Killerpk06/racebot_newchassis/64474a38-f25e-43dd-9ca9-c614ded4e5b5.png

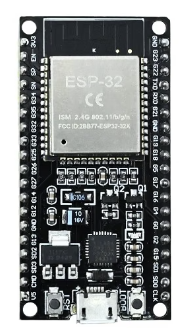
64474a38-f25e-43dd-9ca9-c614ded4e5b5.png
