Killerpk06/racebot_newchassis/chassis/racebot_chassis_iso.png

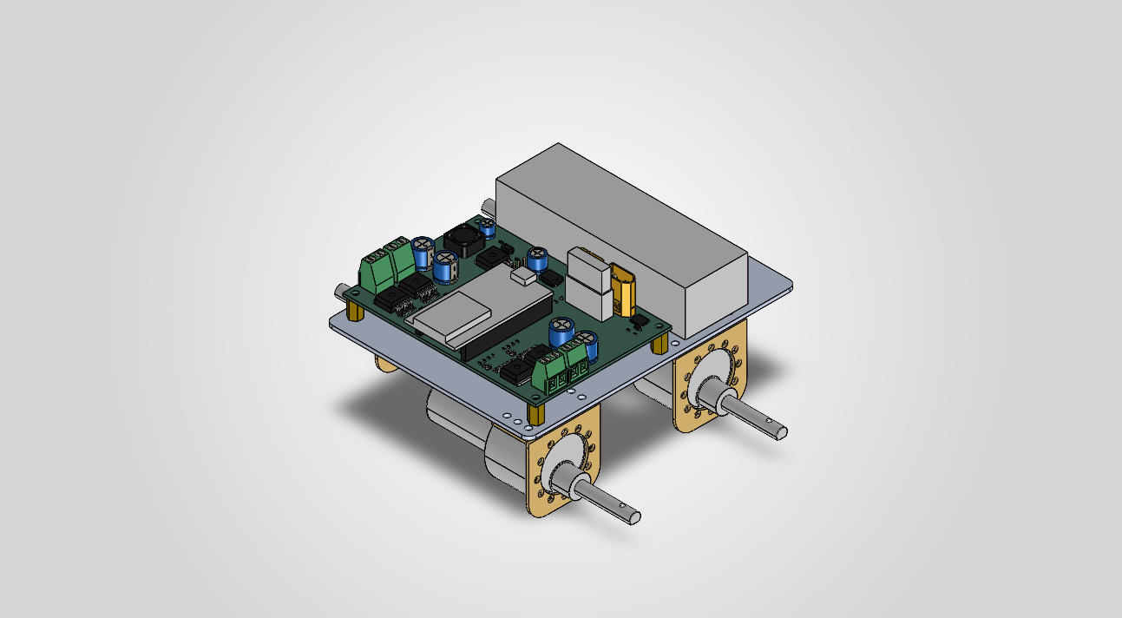
chassis/racebot_chassis_iso.png
