Killerpk06/racebot_newchassis/WhatsApp Image 2026-10-13 at 14.18.45.jpeg

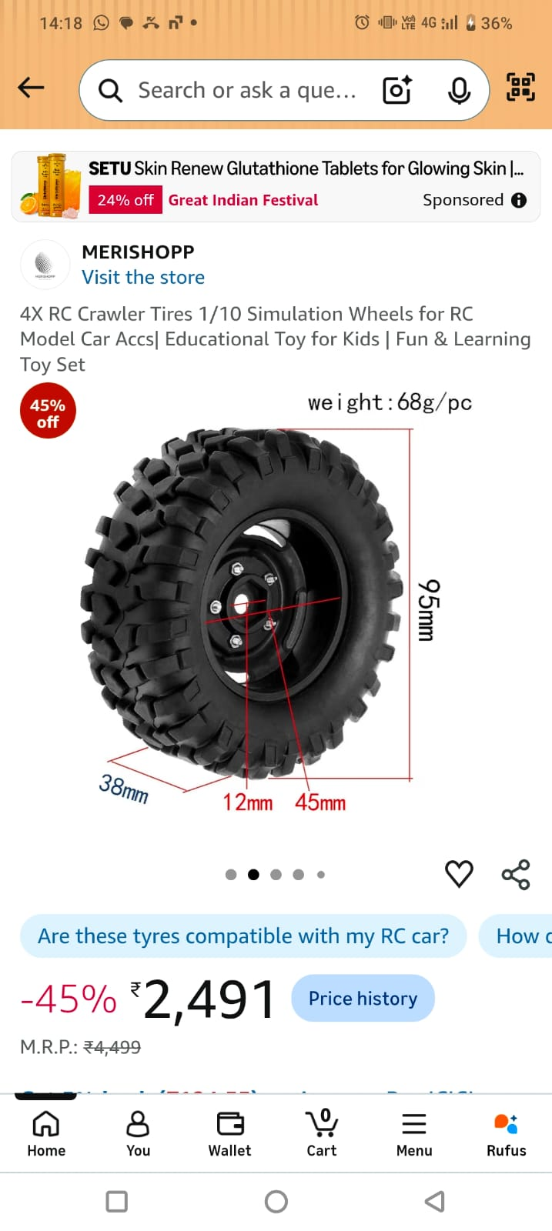
WhatsApp Image 2026-10-13 at 14.18.45.jpeg
