Killerpk06/racebot_newchassis/pcb/racebot_main_bom.csv

Designator | Value | Footprint | MPN | LCSC | Qty | Note
C101 | 220uF 35V | Capacitor_THT:CP_Radial_D8.0mm_P3.50mm | NXH35V220M8*11.5 3.5TP | C346959 | 1
C102,C104,C105,C301,C403,C406,C503,C506 | 100nF 50V X7R | Capacitor_SMD:C_0603_1608Metric | CC0603KRX7R9BB104 | C14663 | 8
C103 | 220uF 16V low-ESR | Capacitor_THT:CP_Radial_D6.3mm_P2.50mm | 16YXJ220M6.3X11 | C88757 | 1
C401,C404,C501,C504 | 10nF 50V X7R | Capacitor_SMD:C_0603_1608Metric | 0603B103K500NT | C57112 | 4
C402,C405,C502,C505 | 470nF 50V X7R | Capacitor_SMD:C_0805_2012Metric | CL21B474KBFNNNE | C13967 | 4
C407,C408,C507,C508 | 470uF 25V low-ESR | Capacitor_THT:CP_Radial_D10.0mm_P5.00mm | GA25V470M10X12 | C51018322 | 4
D101 | BZT52C12 | Diode_SMD:D_SOD-123 | LBZT52C12T1G | C12747 | 1
D102 | SMCJ15A | Diode_SMD:D_SMC | SMCJ15A-13-F | C135138 | 1 | Unidirectional TVS 15 V standoff, clamps ~24.4 V
D103 | SS34 | Diode_SMD:D_SMA | SS34 | C8678 | 1
D104 | RED 5V | LED_SMD:LED_0603_1608Metric | KT-0603R | C2286 | 1
D105 | RED VMOT | LED_SMD:LED_0603_1608Metric | KT-0603R | C2286 | 1
D201 | RED STATUS | LED_SMD:LED_0603_1608Metric | KT-0603R | C2286 | 1
D401,D402,D501,D502 | BAT54S | Package_TO_SOT_SMD:SOT-23 | BAT54S | C8592 | 4
F101 | 30A ATO | Fuse:FuseHolder_Blade_ATO_Littelfuse_FLR_178.6165 | 178.6165.0002 | C207061 | 1 | ATO holder; fit 30 A ATO blade fuse
J101 | XT60 BATTERY | Connector_AMASS:AMASS_XT60-M_1x02_P7.20mm_Vertical | XT60PB-M.G.Y | C19268037 | 1 | vertical; pin1 (bevelled end) = -, pin2 = +. Check against battery plug
J102 | PWR SWITCH / KILL LINK | Connector_AMASS:AMASS_XT60-F_1x02_P7.20mm_Vertical | XT60PB-F.G.Y | C19268038 | 1 | Plug a shorted XT60 link, or a >=30 A switch on an XT60 lead. See LAYOUT_NOTES.md
J201 | ESP32 DevKit left row | Connector_PinSocket_2.54mm:PinSocket_1x19_P2.54mm_Vertical | 2.54-1*19PFemale | C319202 | 1
J202 | ESP32 DevKit right row | Connector_PinSocket_2.54mm:PinSocket_1x19_P2.54mm_Vertical | 2.54-1*19PFemale | C319202 | 1
J203 | ELRS RX (5V GND TX RX) | Connector_PinHeader_2.54mm:PinHeader_1x04_P2.54mm_Vertical | PZ254V-11-04P | C492403 | 1
J401 | M_L1 | TerminalBlock_Phoenix:TerminalBlock_Phoenix_MKDS-1,5-2-5.08_1x02_P5.08mm_Horizontal | 1729128 | C7509570 | 1 | front pad = L_OUT_A
J402 | M_L2 | TerminalBlock_Phoenix:TerminalBlock_Phoenix_MKDS-1,5-2-5.08_1x02_P5.08mm_Horizontal | 1729128 | C7509570 | 1 | front pad = L_OUT_A
J501 | M_R1 | TerminalBlock_Phoenix:TerminalBlock_Phoenix_MKDS-1,5-2-5.08_1x02_P5.08mm_Horizontal | 1729128 | C7509570 | 1 | front pad = R_OUT_A
J502 | M_R2 | TerminalBlock_Phoenix:TerminalBlock_Phoenix_MKDS-1,5-2-5.08_1x02_P5.08mm_Horizontal | 1729128 | C7509570 | 1 | front pad = R_OUT_A
L101 | 33uH 4.6A | Inductor_SMD:L_Bourns_SRR1260 | SRR1260-330M | C840528 | 1
Q101 | CSD18540Q5B | Package_TO_SOT_SMD:TDSON-8-1 | CSD18540Q5B | C86513 | 1
R101,R301,R302,R303,R304,R305,R306,R401,R402,R406,R407,R501,R502,R506,R507 | 10k | Resistor_SMD:R_0603_1608Metric | 0603WAF1002T5E | C25804 | 15 | IN series,INH series,boot pull-down
R102,R103 | 100k | Resistor_SMD:R_0603_1608Metric | 0603WAF1003T5E | C25803 | 2
R104 | 22k | Resistor_SMD:R_0603_1608Metric | 0603WAF2202T5E | C31850 | 1
R105,R201,R405,R410,R505,R510 | 1k | Resistor_SMD:R_0603_1608Metric | 0603WAF1001T5E | C21190 | 6 | IS RC filter
R106 | 4.7k | Resistor_SMD:R_0603_1608Metric | 0603WAF4701T5E | C23162 | 1
R403,R408,R503,R508 | 5.1k | Resistor_SMD:R_0603_1608Metric | 0603WAF5101T5E | C23186 | 4 | slew: fit 0R / 51k to tune
R404,R409,R504,R509 | 470 | Resistor_SMD:R_0603_1608Metric | 0603WAF4700T5E | C23179 | 4 | IS load
U101 | LM2596S-5.0 | Package_TO_SOT_SMD:TO-263-5_TabPin3 | LM2596S-5.0/NOPB | C116713 | 1
U301 | 74HCT244 | Package_SO:SOIC-20W_7.5x12.8mm_P1.27mm | 74HCT244D,653 | C5978 | 1
U401,U402,U501,U502 | BTS7960B | Package_TO_SOT_SMD:TO-263-7_TabPin8 | BTS7960B | C5122776 | 4
