Killerpk06/racebot_newchassis/pcb/mech/racebot_main_outline.dxf

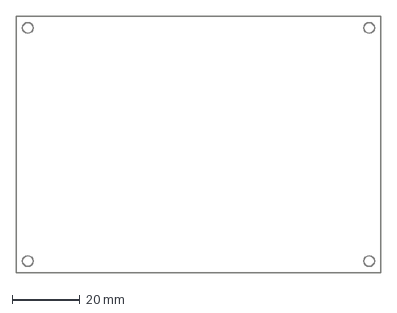
[picture p4: CAD file, 2026-10-28]
pcb/mech/racebot_main_outline.dxf
108.0 x 76.0 mm
