Killerpk06/racebot_newchassis/pcb/mech/racebot_main.step

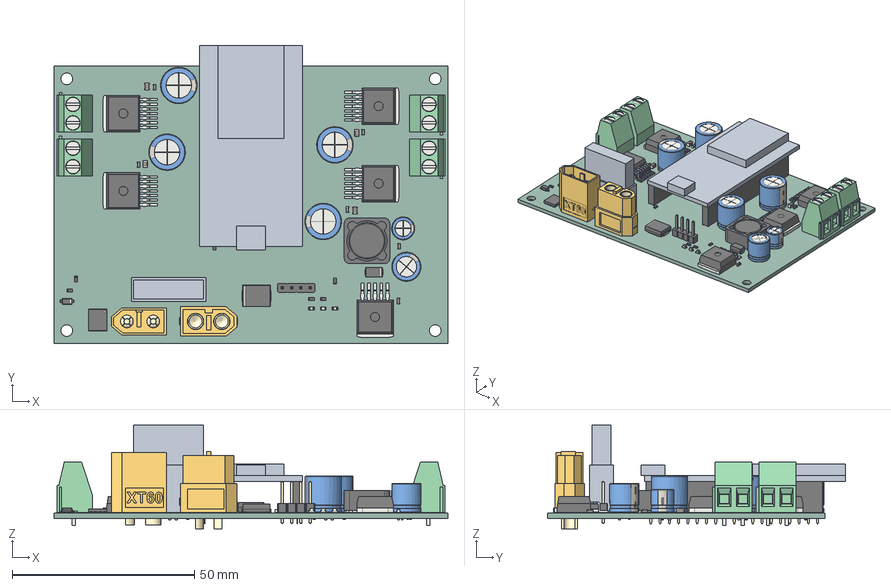
[picture p5: CAD file, 2026-10-28]
pcb/mech/racebot_main.step
108.0 x 81.6 x 28.5 mm
D_SOD-123
C_0603_1608Metric x 12
SOT-23 x 4
a87cca41-9c39-11ed-93f0-dde97e994e83_part x 4
a87cca42-9c39-11ed-93f0-dde97e994e83_part x 4
a87cca43-9c39-11ed-93f0-dde97e994e83_part x 4
R_0603_1608Metric x 33
LED_0603_1608Metric x 3
CP_Radial_D100mm_P500mm x 4
C_0805_2012Metric x 4
TerminalBlock_Phoenix_MKDS-1,5-2-5.08_1x02_P5.08mm_Horizontal x 4
D_SMC
CP_Radial_D80mm_P350mm
D_SMA
XT60 male v2
PinSocket_1x19_P2.54mm_Vertical x 2
SRR1260
a648ce37-9c39-11ed-93f0-dde97e994e83_part
a648ce38-9c39-11ed-93f0-dde97e994e83_part
a648ce39-9c39-11ed-93f0-dde97e994e83_part
TDSON_8_1
CP_Radial_D63mm_P250mm
XT60 female v5
PinHeader_1x04_P254mm_Vertical
SOIC-20W_7.5x12.8mm_P1.27mm
racebot_main_PCB
