Killerpk06/racebot_newchassis/chassis/parts/johnson_L_clamp.step

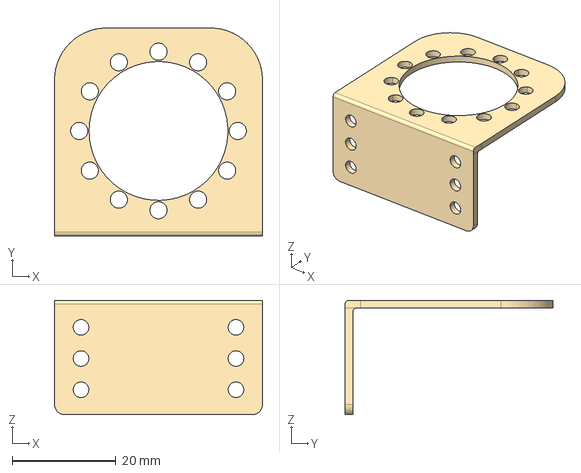
[picture p6: CAD file, 2026-10-28]
chassis/parts/johnson_L_clamp.step
40.0 x 40.0 x 22.0 mm
