Killerpk06/racebot_newchassis/chassis/racebot_chassis.step

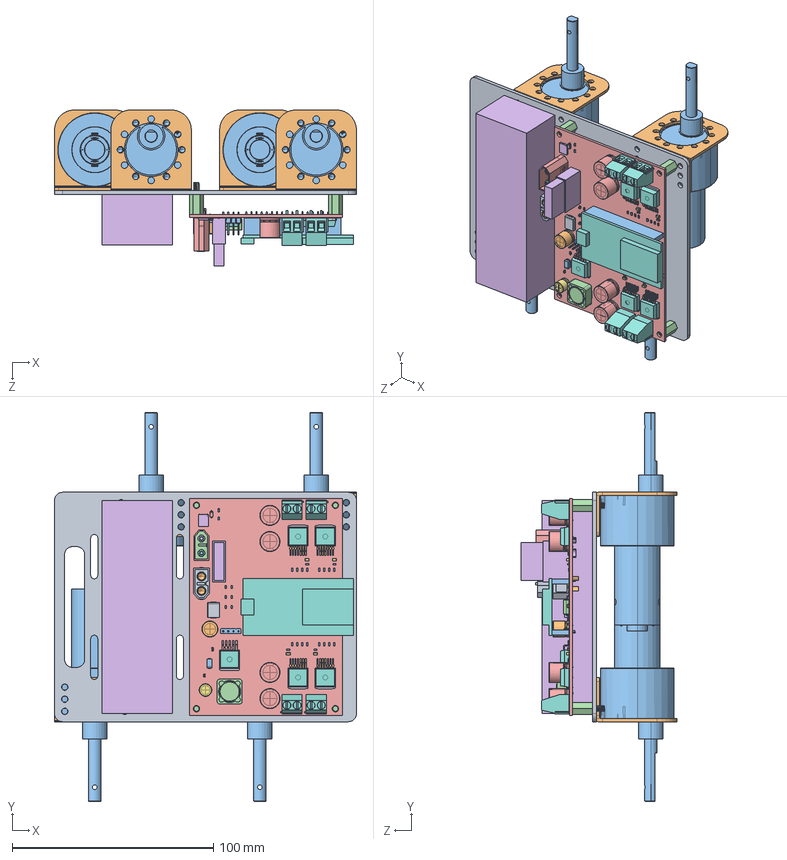
[picture p7: CAD file, 2026-10-28]
chassis/racebot_chassis.step
150.0 x 193.2 x 77.6 mm
racebot_deck
johnson_L_clamp x 4
johnson_motor x 4
M3x10_spacer x 4
D_SOD-123-0.step
C_0603_1608Metric-1.step x 12
SOT-23-2.step x 4
a87cca41-9c39-11ed-93f0-dde97e994e83_part.step x 4
a87cca42-9c39-11ed-93f0-dde97e994e83_part.step x 4
a87cca43-9c39-11ed-93f0-dde97e994e83_part.step x 4
R_0603_1608Metric-3.step x 33
LED_0603_1608Metric-4.step x 3
CP_Radial_D100mm_P500mm.step x 4
C_0805_2012Metric-5.step x 4
TerminalBlock_Phoenix_MKDS-1,5-2-5.08_1x02_P5.08mm_Horizontal-6.step x 4
D_SMC-7.step
CP_Radial_D80mm_P350mm.step
D_SMA-8.step
XT60 male v2.step
PinSocket_1x19_P2.54mm_Vertical-9.step x 2
SRR1260.step
a648ce37-9c39-11ed-93f0-dde97e994e83_part.step
a648ce38-9c39-11ed-93f0-dde97e994e83_part.step
a648ce39-9c39-11ed-93f0-dde97e994e83_part.step
TDSON_8_1.step
CP_Radial_D63mm_P250mm.step
XT60 female v5.step
PinHeader_1x04_P254mm_Vertical.step
SOIC-20W_7.5x12.8mm_P1.27mm-10.step
racebot_main_PCB.step
battery_3S_2200_envelope
