Killerpk06/racebot_newchassis/pcb/3d/XT60_male_vertical.step

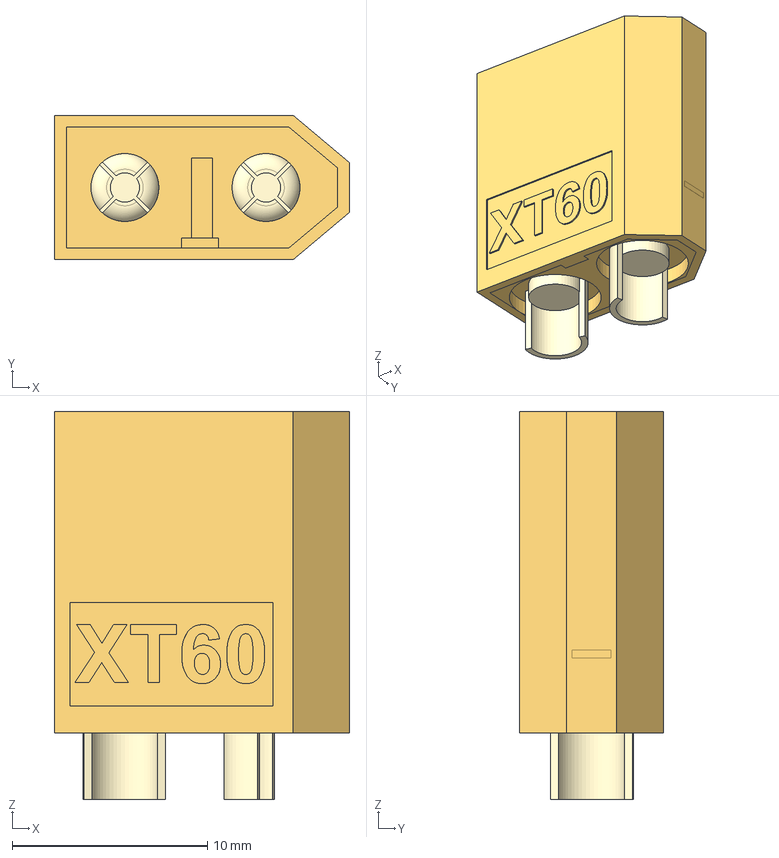
[picture p8: CAD file, 2026-10-28]
pcb/3d/XT60_male_vertical.step
15.1 x 7.40 x 19.9 mm
