Killerpk06/racebot_newchassis/Robo Race chasis final.dxf

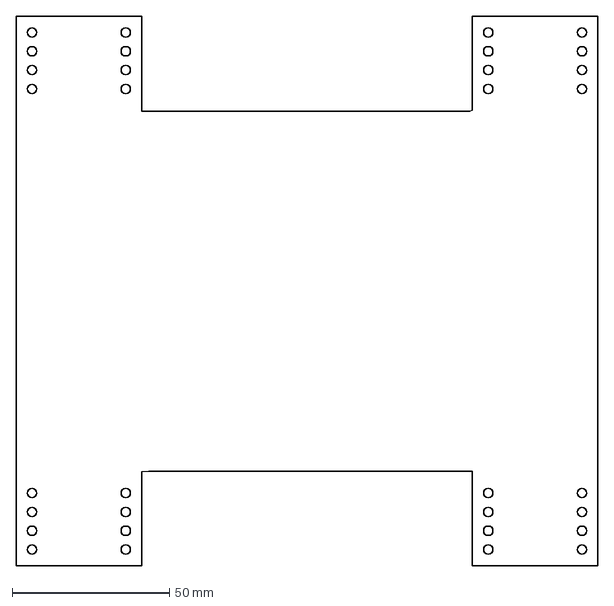
[picture p9: CAD file, 2026-10-28]
Robo Race chasis final.dxf
185.2 x 175.0 mm
