Killerpk06/racebot_newchassis/chassis/racebot_deck_2mm_6061.dxf

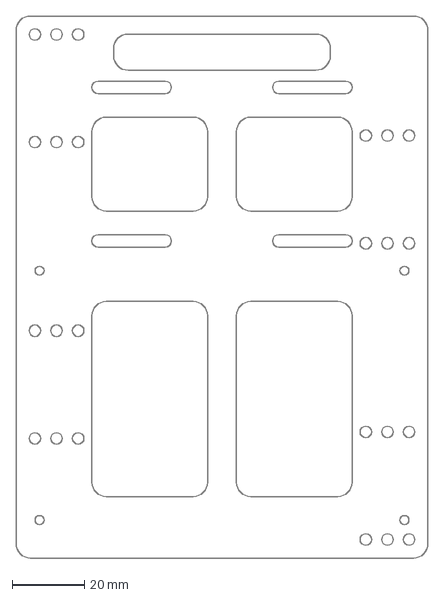
[picture p10: CAD file, 2026-10-28]
chassis/racebot_deck_2mm_6061.dxf
114.0 x 150.0 mm
