Killerpk06/racebot_newchassis/pcb/3d/ESP32_DevKit38_on_sockets_envelope.step

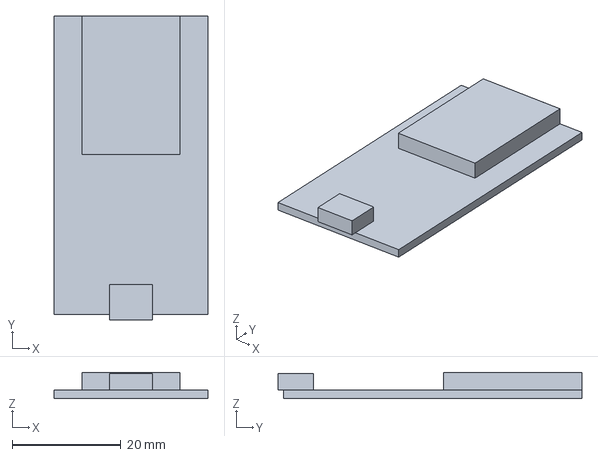
[picture p11: CAD file, 2026-10-28]
pcb/3d/ESP32_DevKit38_on_sockets_envelope.step
28.3 x 56.0 x 4.80 mm
