Killerpk06/racebot_newchassis/chassis/racebot_deck.SLDPRT

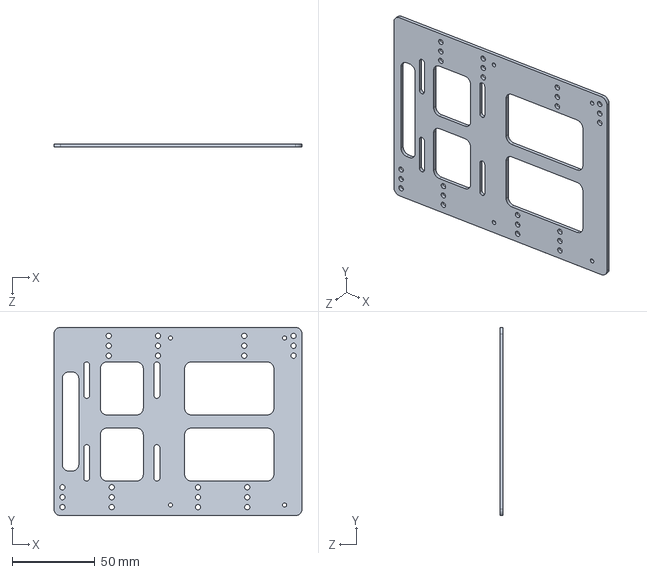
[picture p12: CAD file, 2026-10-28]
chassis/racebot_deck.SLDPRT
150.0 x 114.0 x 2.00 mm
