Killerpk06/racebot_newchassis/pcb/3d/ATO_holder_with_fuse_envelope.step

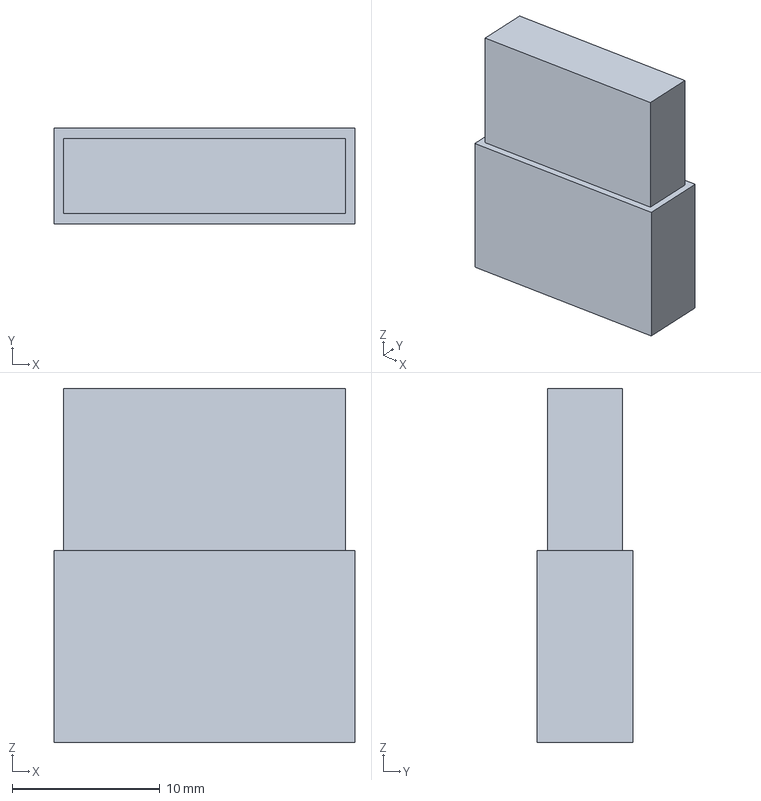
[picture p13: CAD file, 2026-10-28]
pcb/3d/ATO_holder_with_fuse_envelope.step
20.4 x 6.50 x 24.0 mm
