Killerpk06/racebot_newchassis/chassis/parts/johnson_motor.step

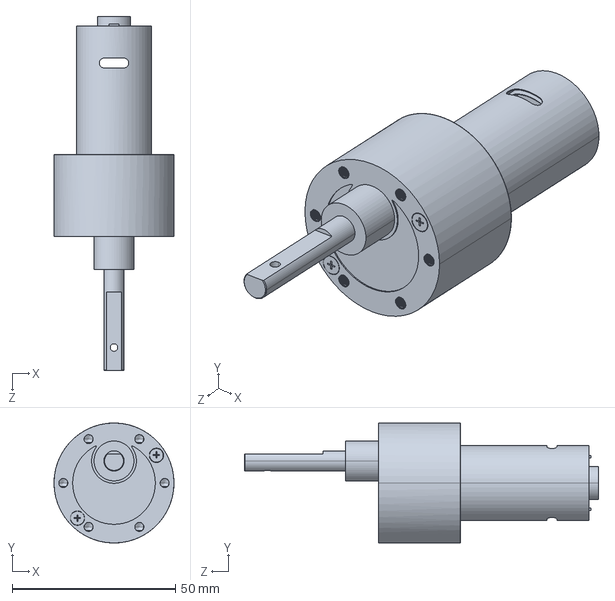
[picture p14: CAD file, 2026-10-28]
chassis/parts/johnson_motor.step
36.7 x 36.7 x 108.4 mm
