Killerpk06/racebot_newchassis/chassis/parts/battery_3S_2200_envelope.SLDPRT

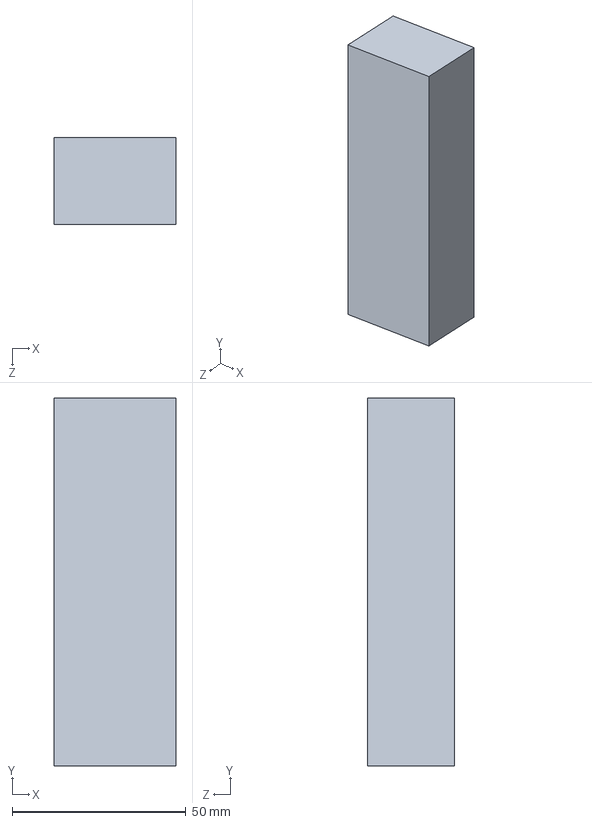
[picture p15: CAD file, 2026-10-28]
chassis/parts/battery_3S_2200_envelope.SLDPRT
35.0 x 106.0 x 25.0 mm
