Killerpk06/racebot_newchassis/chassis/parts/M3x10_spacer.SLDPRT

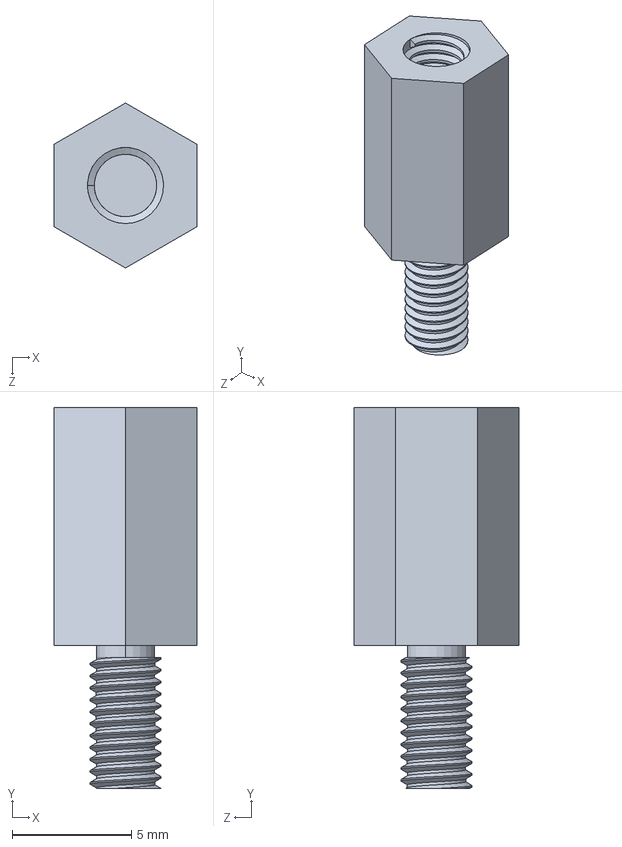
[picture p16: CAD file, 2026-10-28]
chassis/parts/M3x10_spacer.SLDPRT
6.00 x 16.0 x 6.93 mm
