Killerpk06/racebot_newchassis/(list of files, cad)

Other CAD files:
chassis/parts/racebot_pcb.step
chassis/parts/johnson_L_clamp.SLDPRT
chassis/parts/johnson_motor.SLDPRT
chassis/parts/racebot_pcb.SLDASM
chassis/racebot_chassis.SLDASM
