Killerpk06/racebot_newchassis/pcb/racebot_main_schematic.pdf

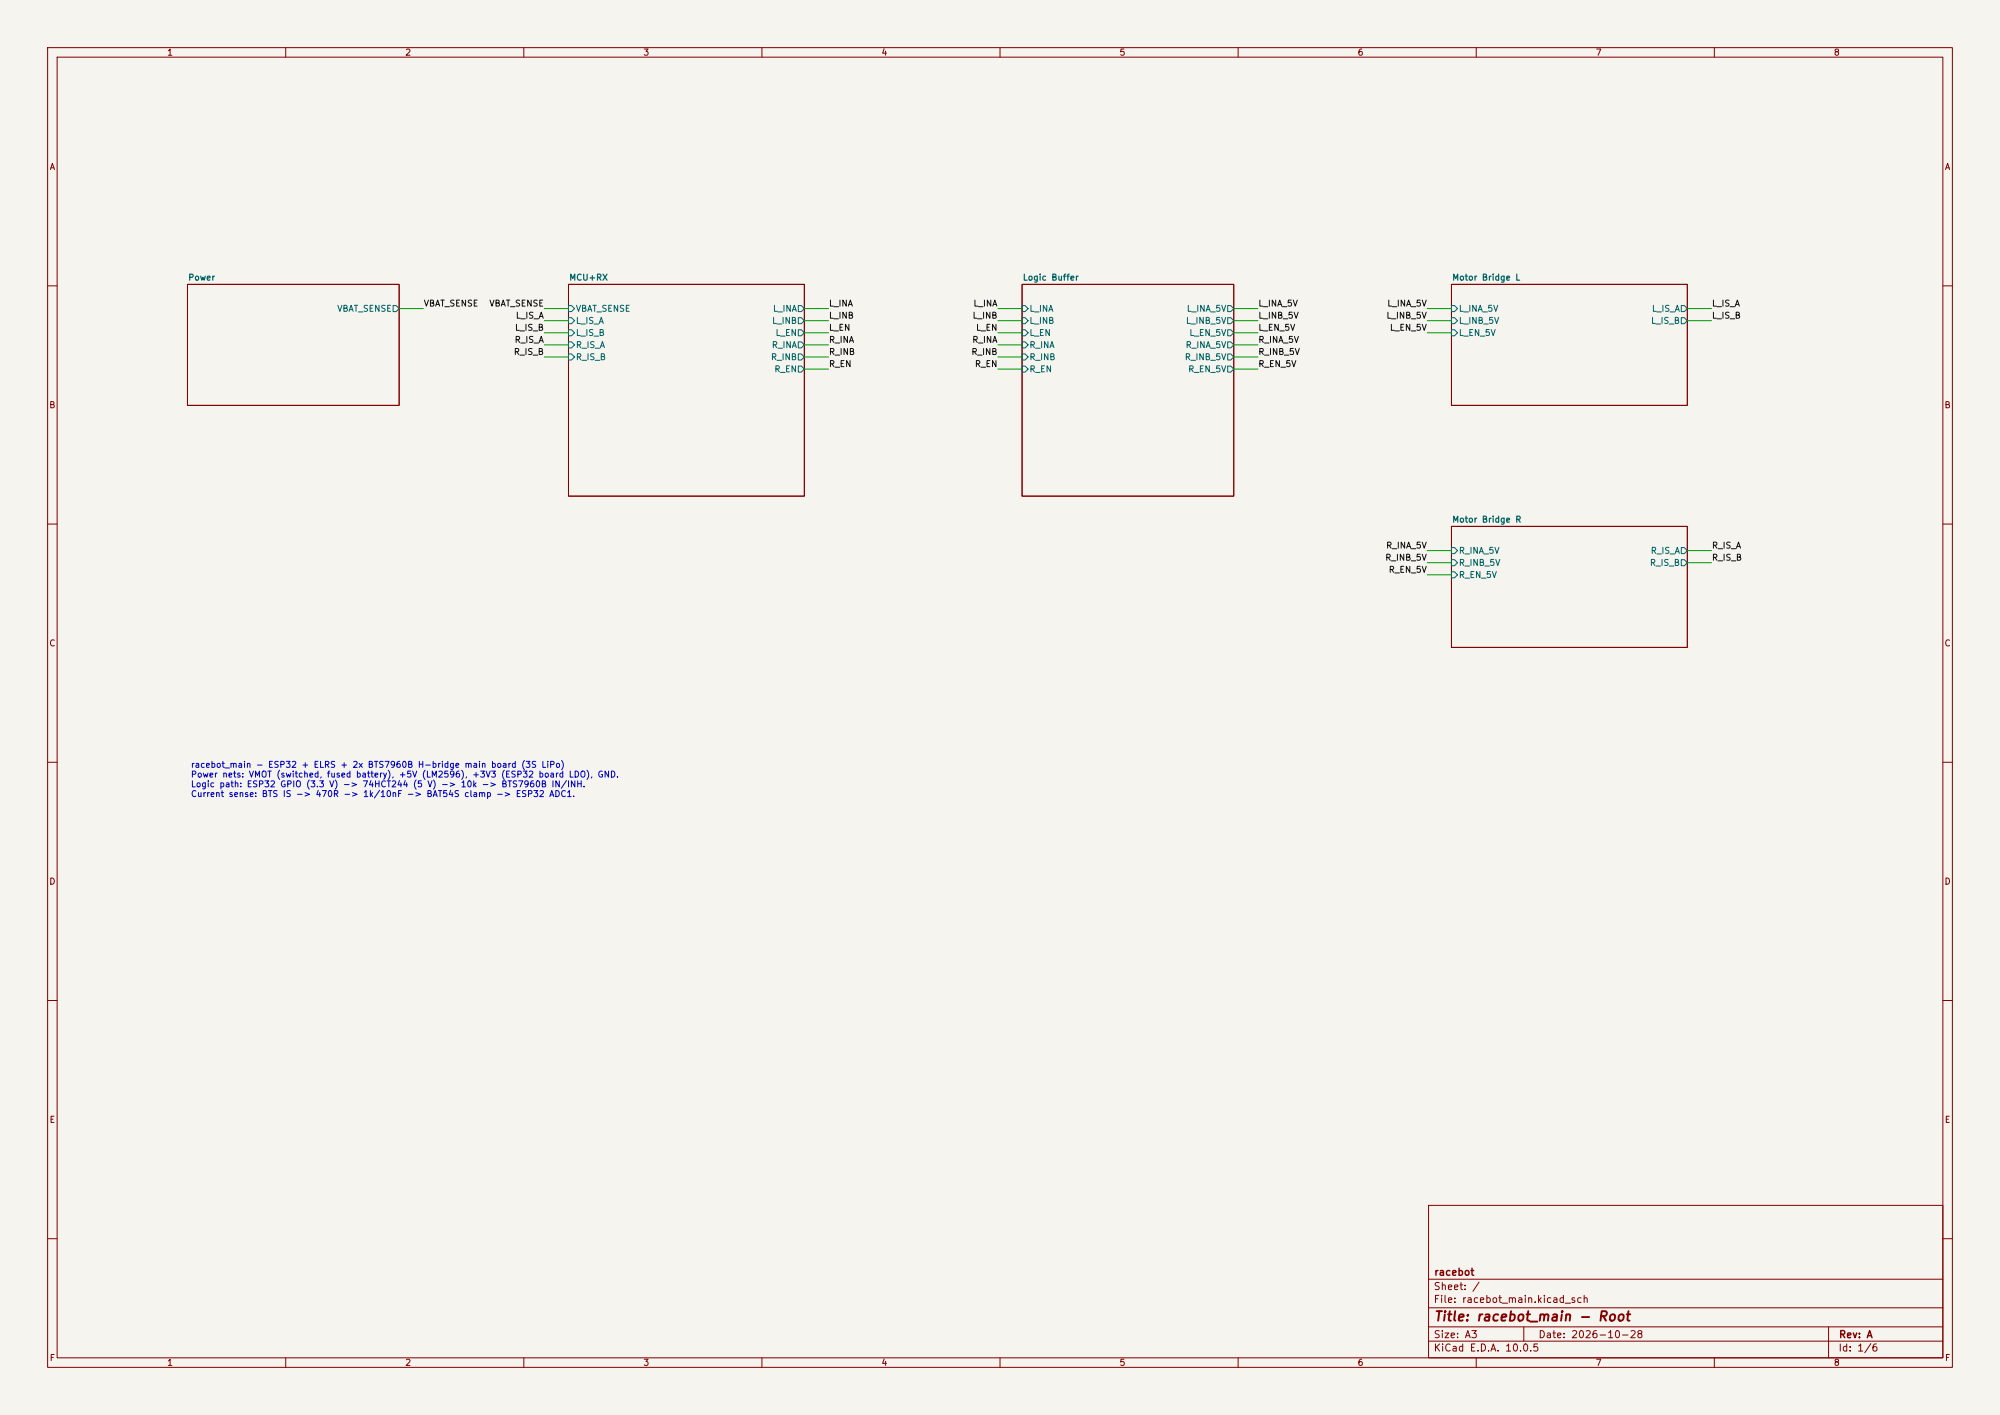
[picture p17: page 1]

racebot_main - ESP32 + ELRS + 2x BTS7960B H-bridge main board (3S LiPo) Power nets: VMOT (switched, fused battery), +5V (LM2596), +3V3 (ESP32 board LDO), GND. Logic path: ESP32 GPIO (3.3 V) -> 74HCT244 (5 V) -> 10k -> BTS7960B IN/INH. Current sense: BTS IS -> 470R -> 1k/10nF -> BAT54S clamp -> ESP32 ADC1.

Size: A3 | Rev: A | F Date: 2026-10-28
KiCad E.D.A. 10.0.5 | Id: 1/6

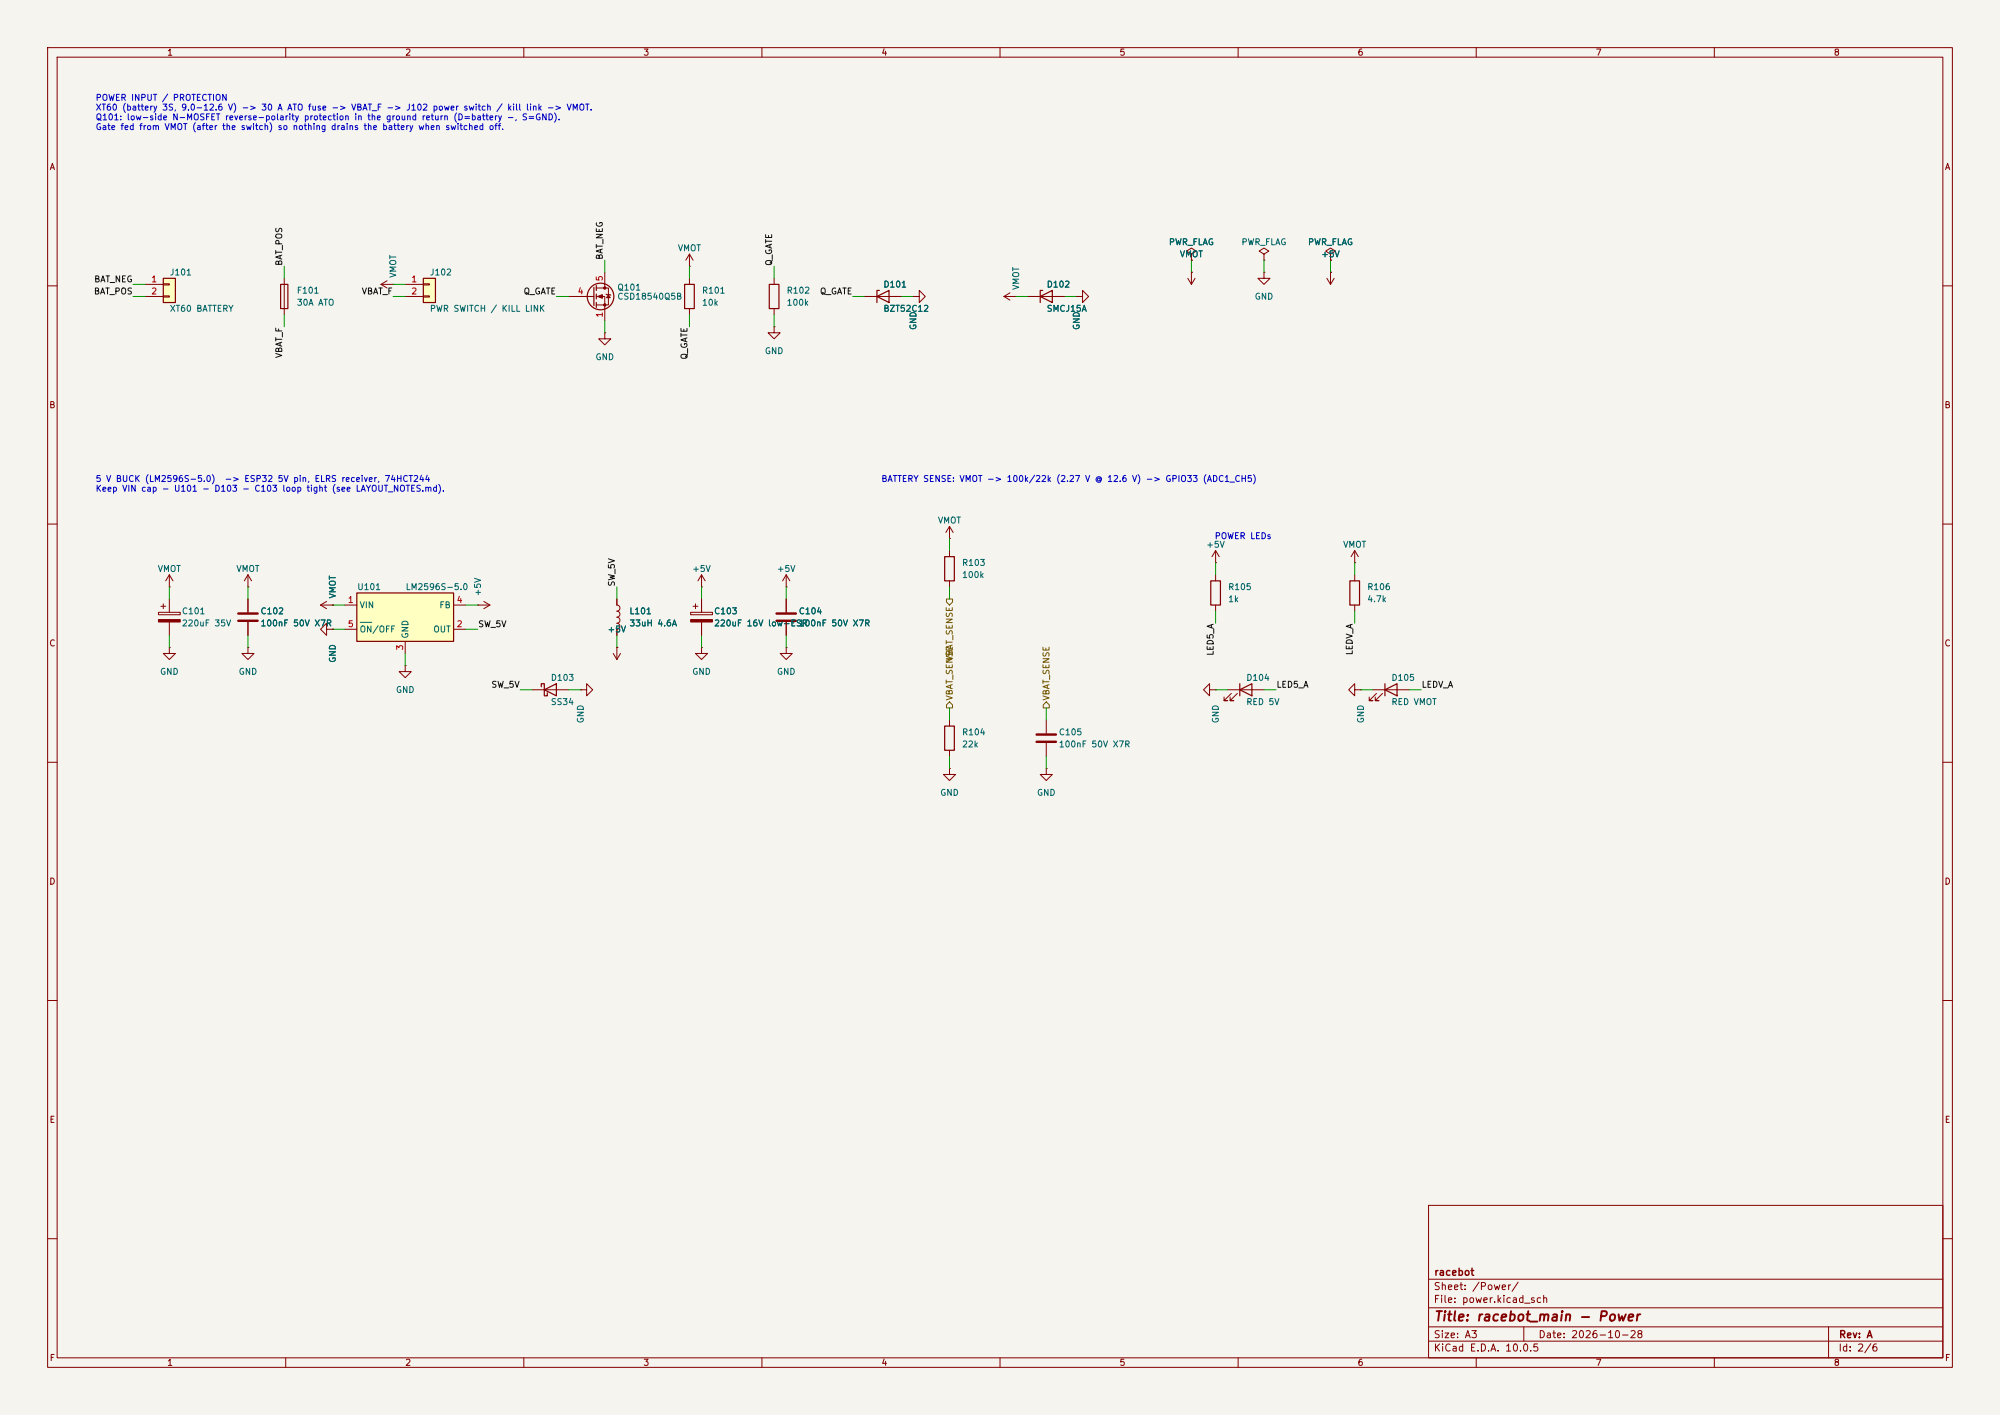
[picture p18: page 2]

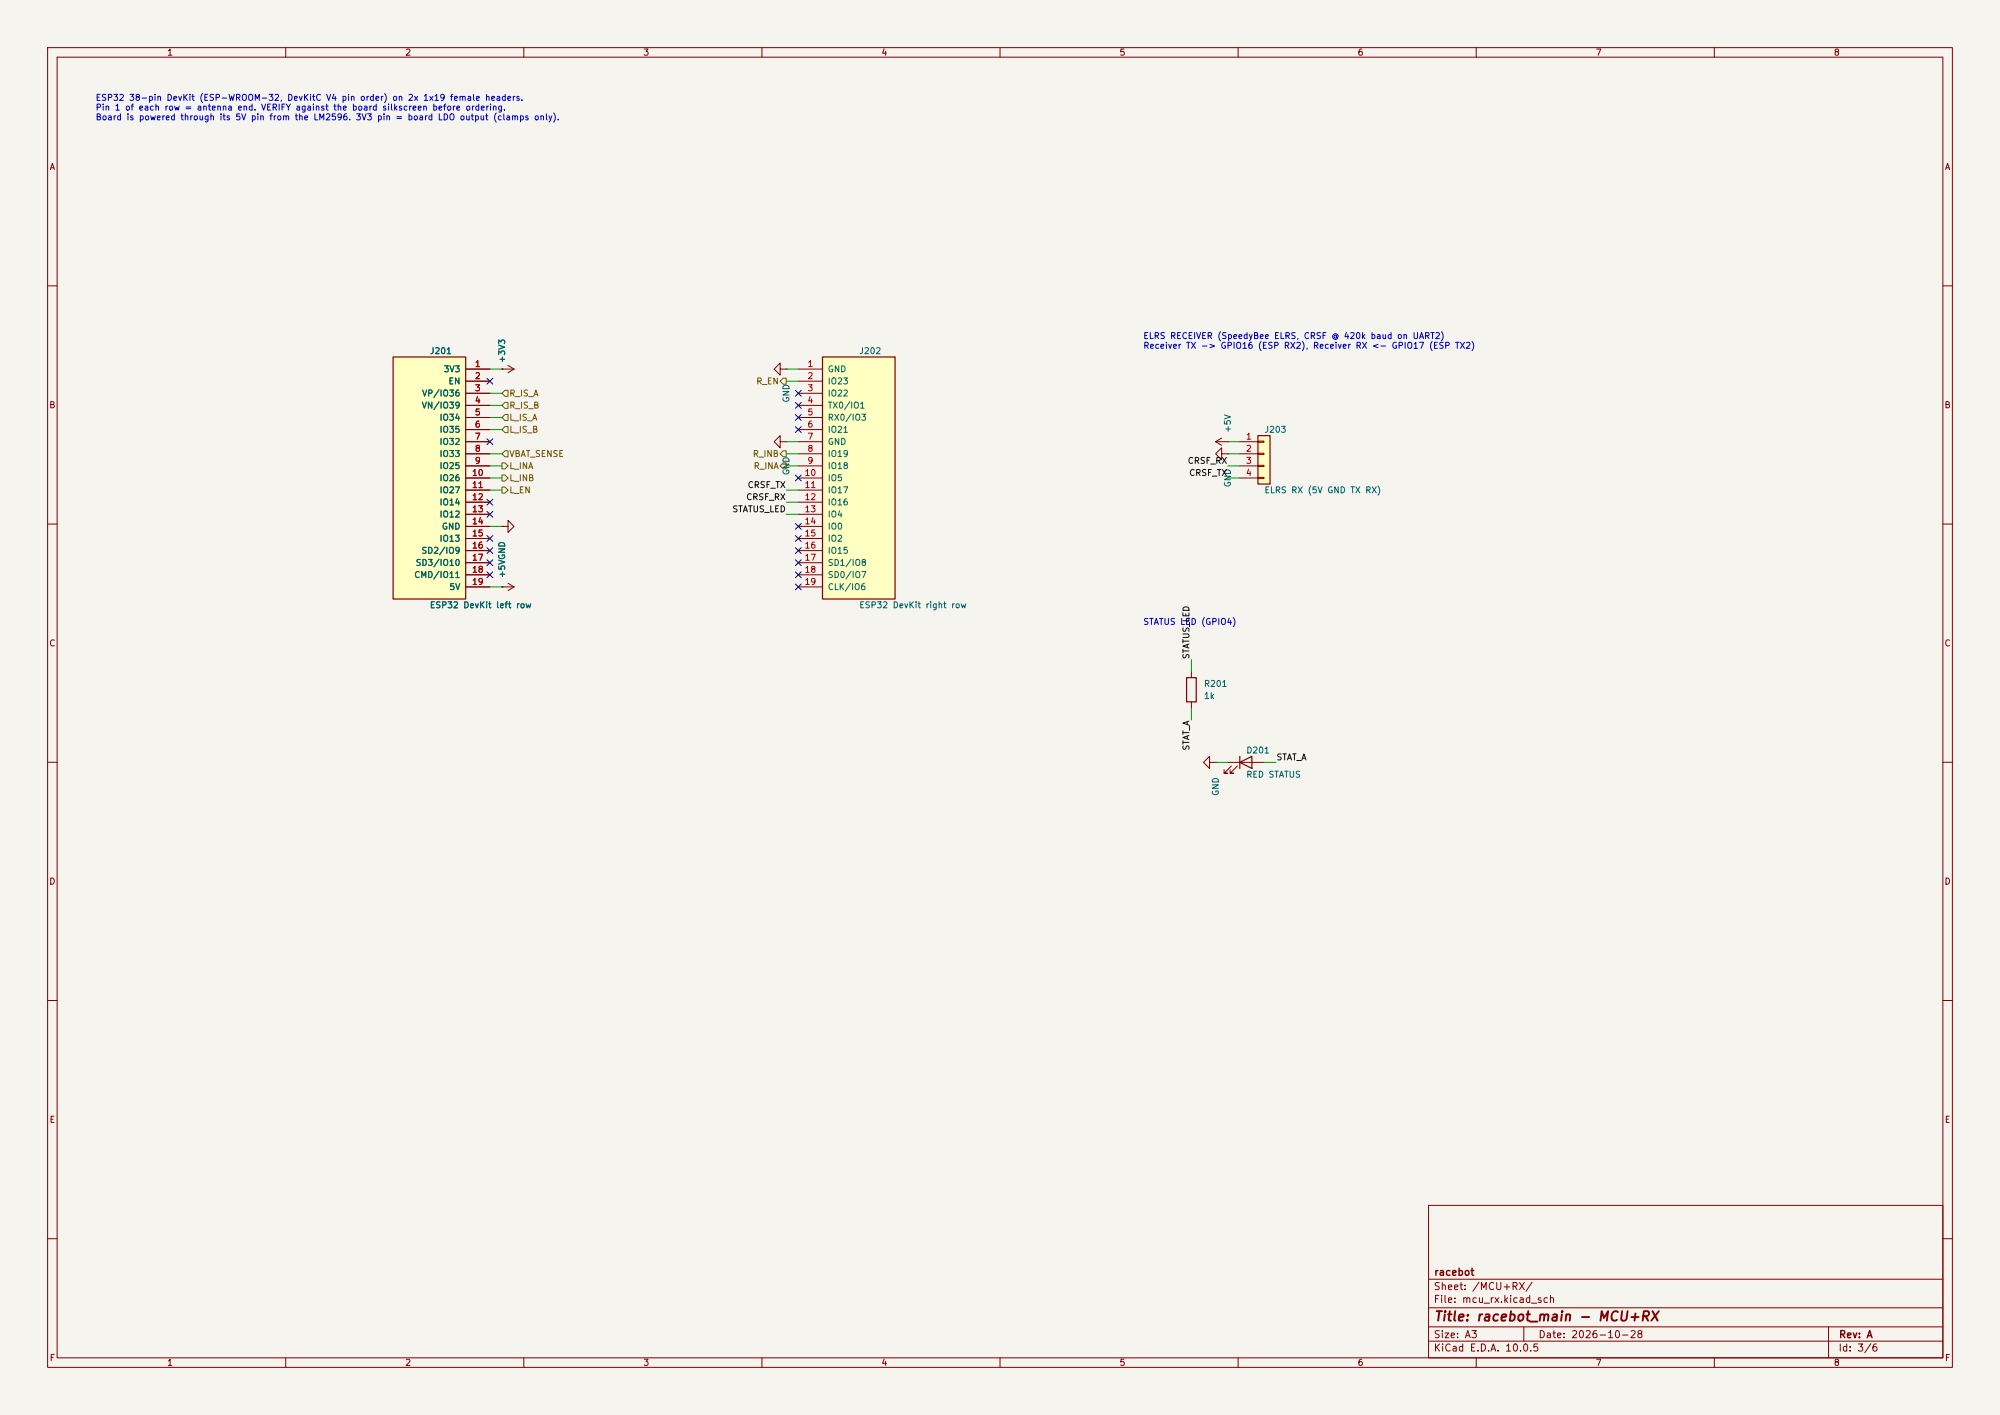
[picture p19: page 3]

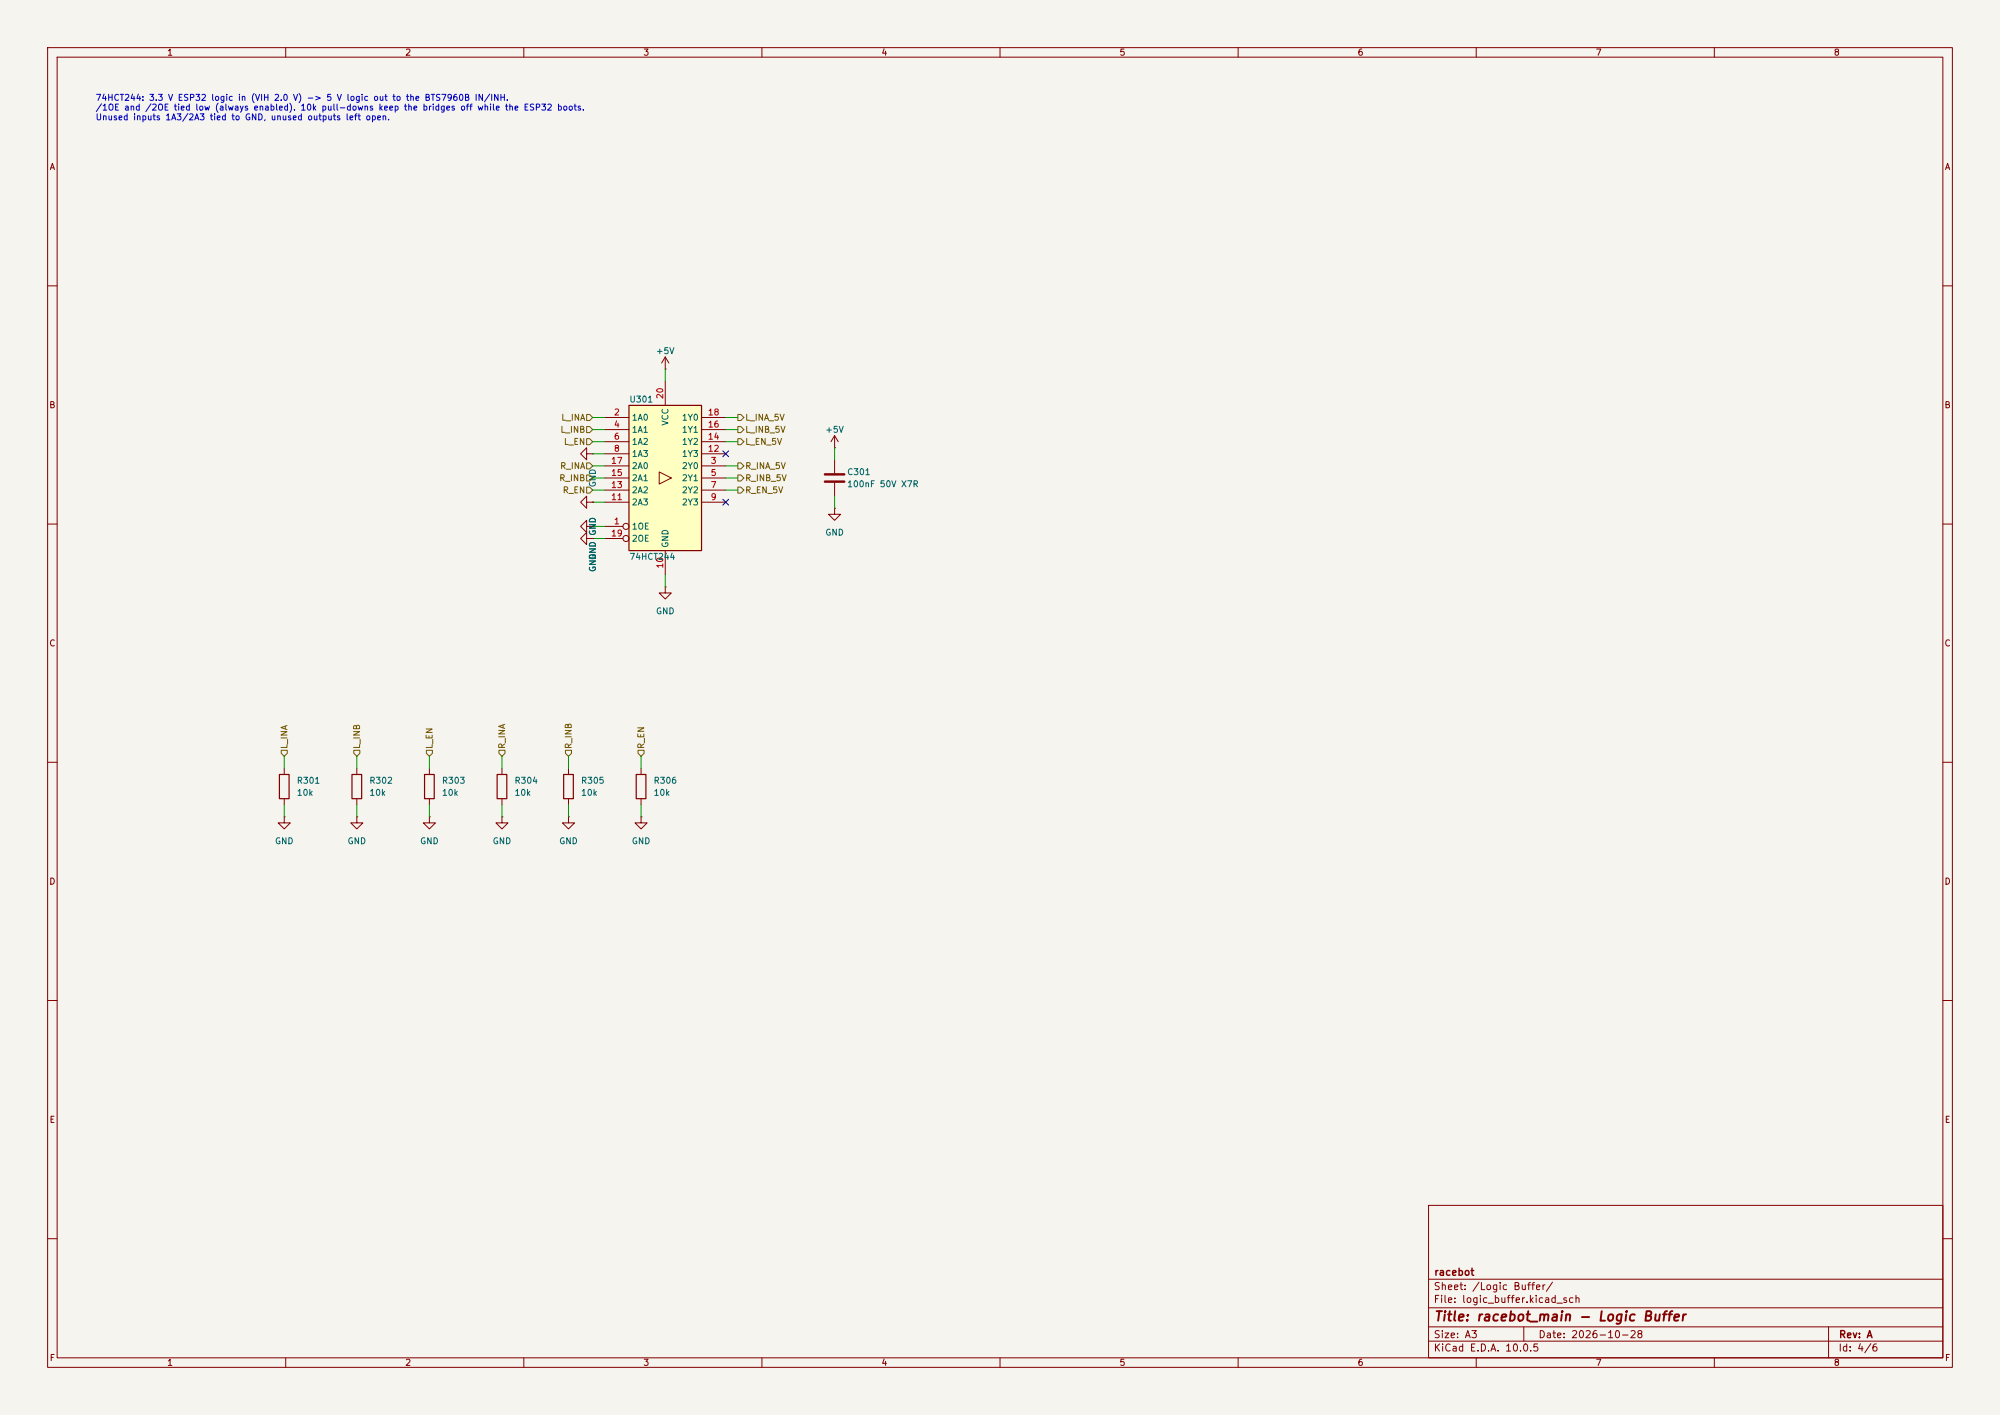
[picture p20: page 4]

R_INA_5V R_INB_5V 74HCT244: 3.3 V ESP32 logic in (VIH 2.0 V) -> 5 V logic out to the BTS7960B IN/INH.

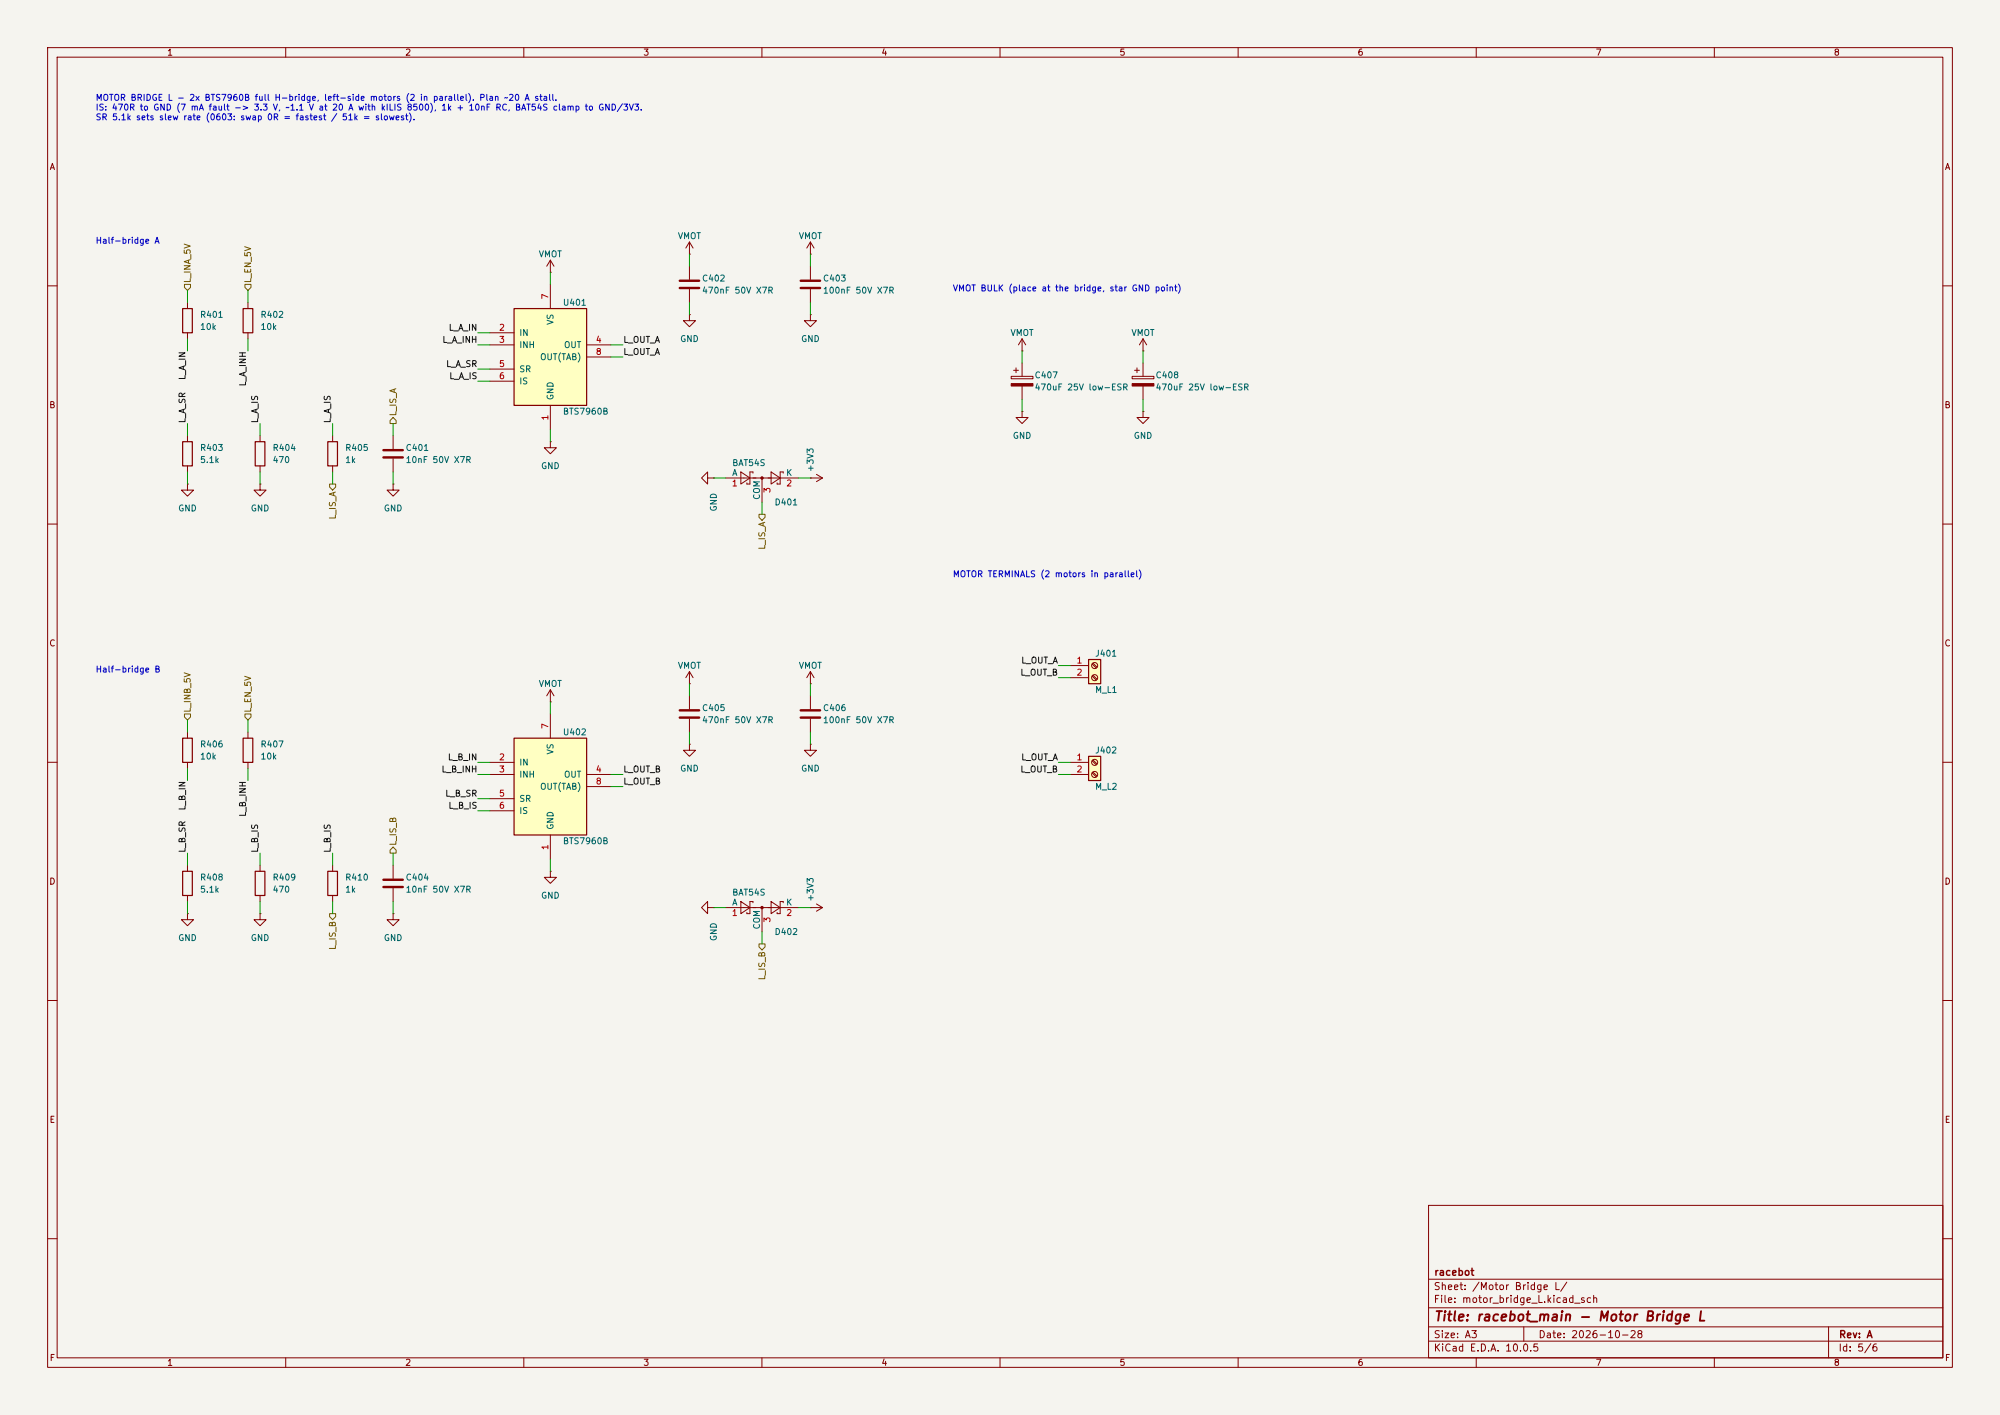
[picture p21: page 5]

MOTOR BRIDGE L - 2x BTS7960B full H-bridge, left-side motors (2 in parallel). Plan ~20 A stall.

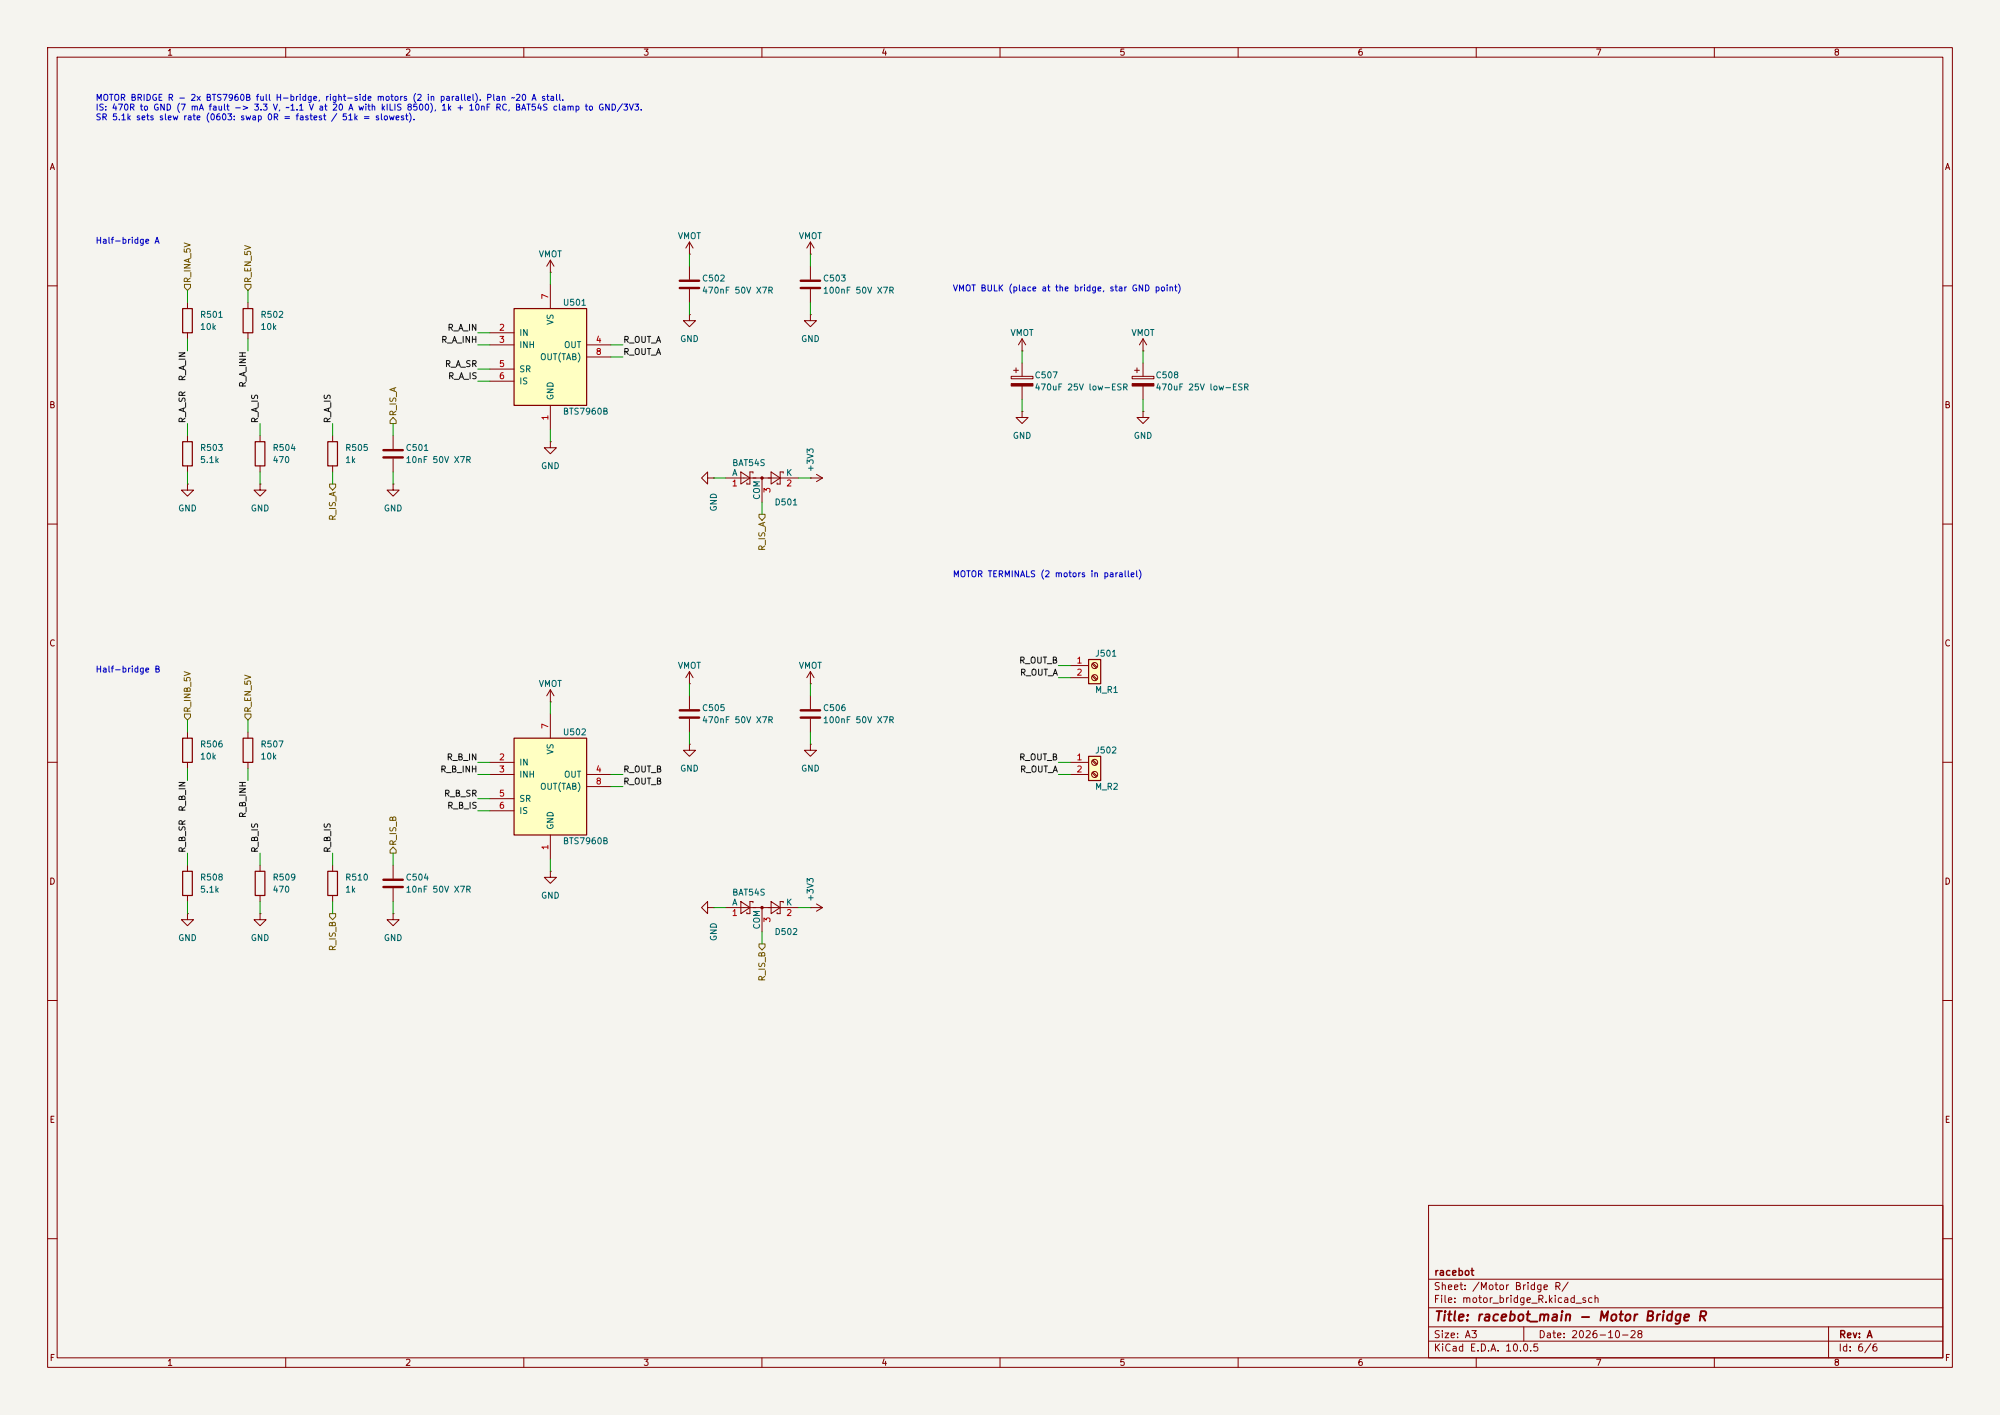
[picture p22: page 6]

IS: 470R to GND (7 mA fault -> 3.3 V, ~1.1 V at 20 A with kILIS 8500), 1k + 10nF RC, BAT54S clamp to GND/3V3. SR 5.1k sets slew rate (0603: swap 0R = fastest / 51k = slowest).

VMOT BULK (place at the bridge, star GND point)
