Killerpk06/racebot_newchassis/pcb/racebot_main.kicad_pcb

## KiCad design pcb/racebot_main.kicad_pcb (2026-10-28)

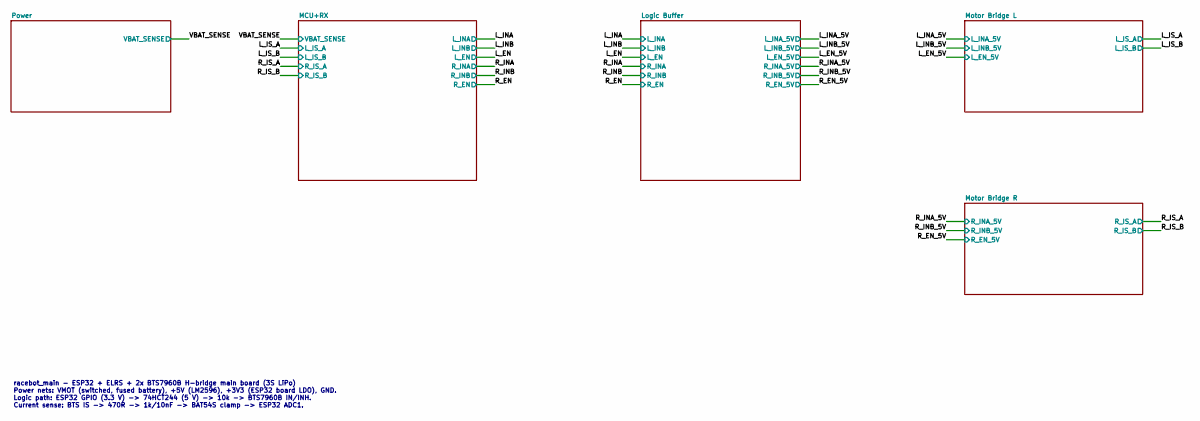
[picture p23: schematic racebot_main.kicad_sch, racebot_main - Root]

Notes on the sheet:
racebot_main - ESP32 + ELRS + 2x BTS7960B H-bridge main board (3S LiPo) Power nets: VMOT (switched, fused battery), +5V (LM2596), +3V3 (ESP32 board LDO), GND. Logic path: ESP32 GPIO (3.3 V) -> 74HCT244 (5 V) -> 10k -> BTS7960B IN/INH. Current sense: BTS IS -> 470R -> 1k/10nF -> BAT54S clamp -> ESP3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

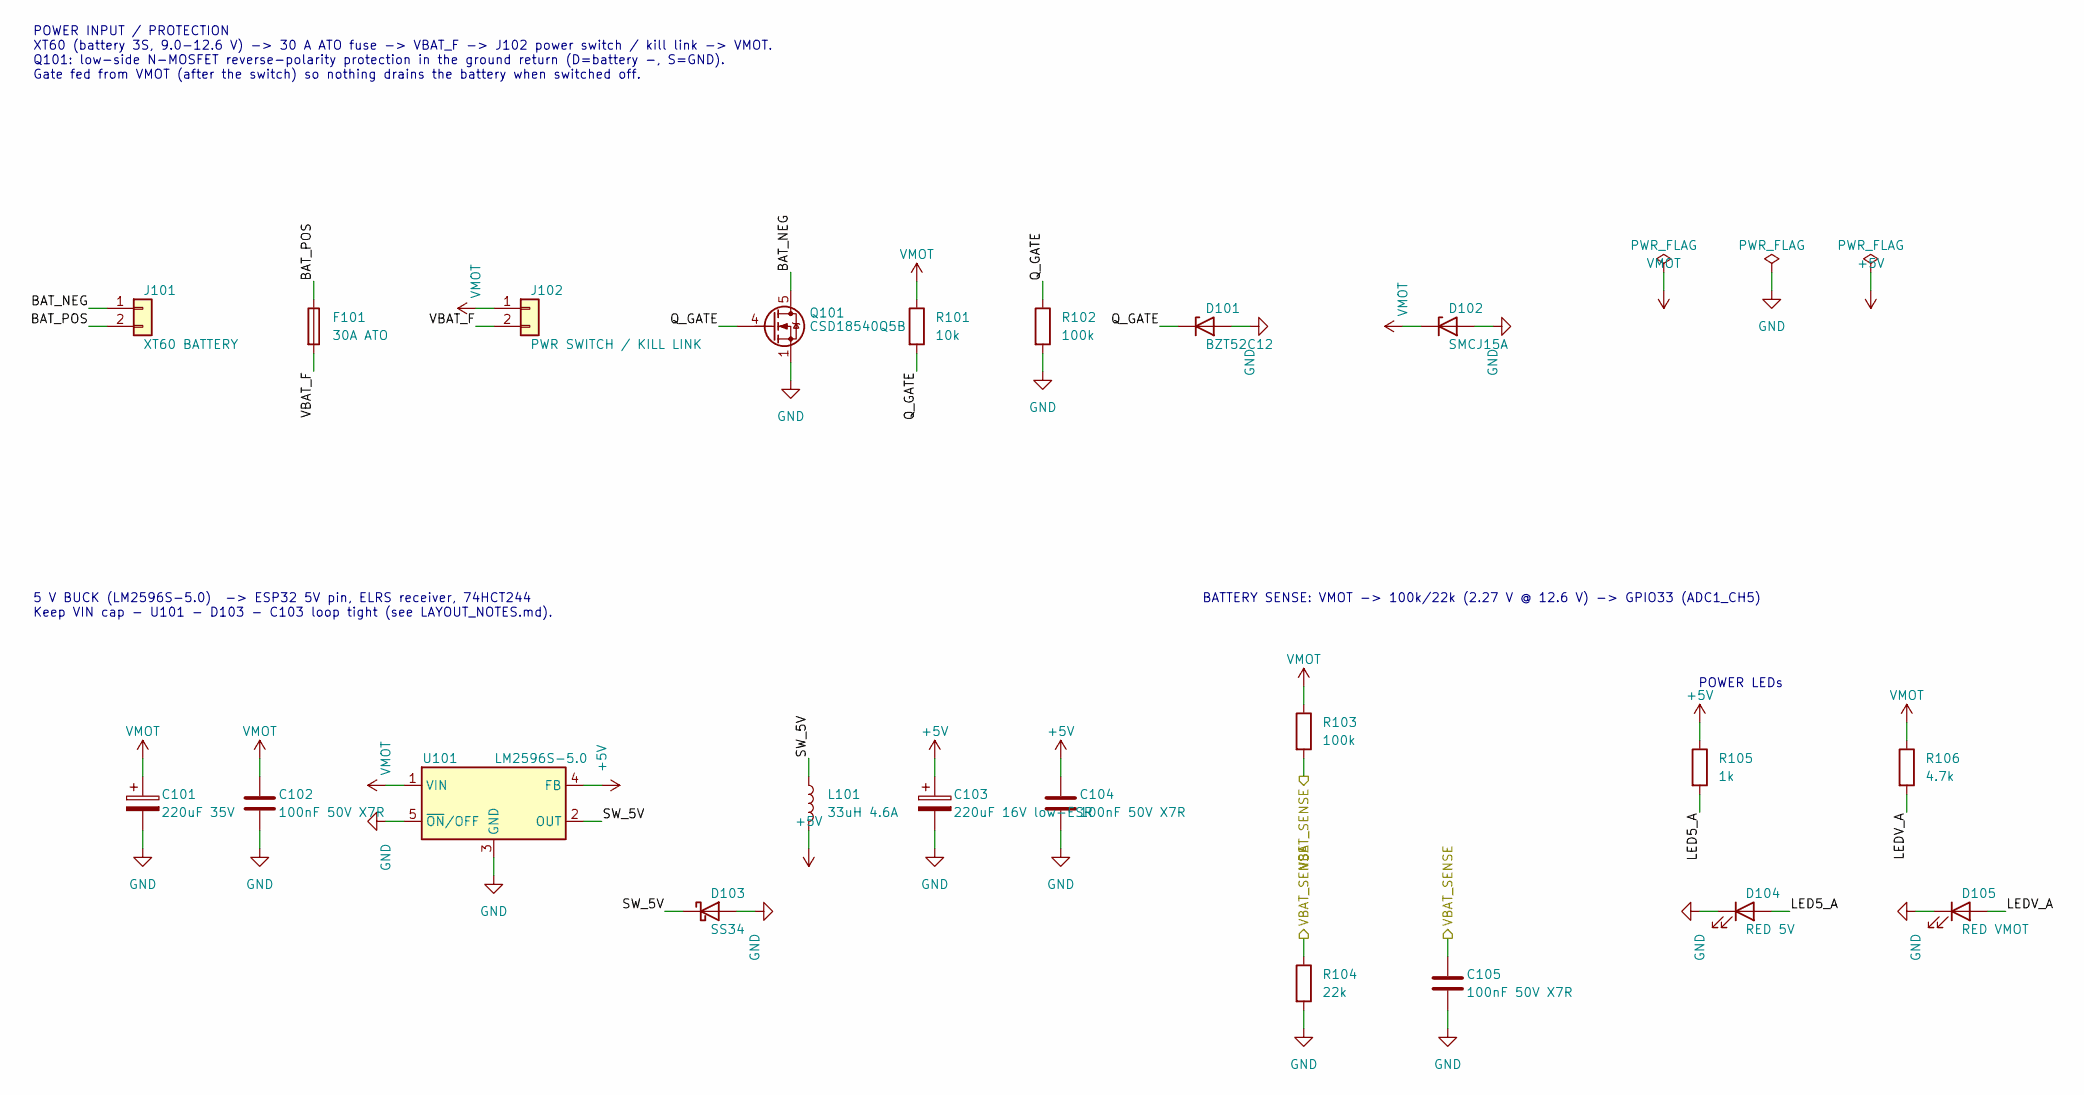
[picture p24: schematic power.kicad_sch, racebot_main - Power]

Parts:
C101: 220uF 35V; CP_Radial_D8.0mm_P3.50mm; MPN NXH35V220M8*11.5 3.5TP; LCSC C346959
C102, C104, C105: 100nF 50V X7R; C_0603_1608Metric; MPN CC0603KRX7R9BB104; LCSC C14663
C103: 220uF 16V low-ESR; CP_Radial_D6.3mm_P2.50mm; MPN 16YXJ220M6.3X11; LCSC C88757
D101: BZT52C12; D_SOD-123; MPN LBZT52C12T1G; LCSC C12747
D102: SMCJ15A; D_SMC; MPN SMCJ15A-13-F; LCSC C135138
D103: SS34; D_SMA; MPN SS34; LCSC C8678
D104: RED 5V; LED_0603_1608Metric; MPN KT-0603R; LCSC C2286
D105: RED VMOT; LED_0603_1608Metric; MPN KT-0603R; LCSC C2286
F101: 30A ATO; FuseHolder_Blade_ATO_Littelfuse_FLR_178.6165; MPN 178.6165.0002; LCSC C207061
J101: XT60 BATTERY; AMASS_XT60PW-M_1x02_P7.20mm_Horizontal; MPN XT60PW-M; LCSC C98732
J102: PWR SWITCH / KILL LINK; AMASS_XT60PW-F_1x02_P7.20mm_Horizontal; MPN XT60PW-F; LCSC C428722
L101: 33uH 4.6A; L_Bourns_SRR1260; MPN SRR1260-330M; LCSC C840528
Q101: CSD18540Q5B; TDSON-8-1; MPN CSD18540Q5B; LCSC C86513
R101: 10k; R_0603_1608Metric; MPN 0603WAF1002T5E; LCSC C25804
R102, R103: 100k; R_0603_1608Metric; MPN 0603WAF1003T5E; LCSC C25803
R104: 22k; R_0603_1608Metric; MPN 0603WAF2202T5E; LCSC C31850
R105: 1k; R_0603_1608Metric; MPN 0603WAF1001T5E; LCSC C21190
R106: 4.7k; R_0603_1608Metric; MPN 0603WAF4701T5E; LCSC C23162
U101: LM2596S-5.0; TO-263-5_TabPin3; MPN LM2596S-5.0/NOPB; LCSC C116713

Connections:
+5V: C103.1, C104.1, L101.2, R105.1, U101.4 (FB); also elsewhere on the board
/Power/BAT_NEG: J101.1, Q101.5 (D)
/Power/BAT_POS: F101.1, J101.2
/Power/LED5_A: D104.2 (A), R105.2
/Power/LEDV_A: D105.2 (A), R106.2
/Power/Q_GATE: D101.1 (K), Q101.4 (G), R101.2, R102.1
/Power/SW_5V: D103.1 (K), L101.1, U101.2 (OUT)
/Power/VBAT_F: F101.2, J102.2
/VBAT_SENSE: C105.1, R103.2, R104.1; also elsewhere on the board
GND: C101.2, C102.2, C103.2, C104.2, C105.2, D101.2 (A), D102.2 (A), D103.2 (A), D104.1 (K), D105.1 (K), Q101.1 (S), Q101.2 (S), Q101.3 (S), R102.2, R104.2, U101.3 (GND), U101.5 (~ON/OFF); also elsewhere on the board
VMOT: C101.1, C102.1, D102.1 (K), J102.1, R101.1, R103.1, R106.1, U101.1 (VIN); also elsewhere on the board

Notes on the sheet:
BATTERY SENSE: VMOT -> 100k/22k (2.27 V @ 12.6 V) -> GPIO33 (ADC1_CH5)
POWER LEDs
POWER INPUT / PROTECTION XT60 (battery 3S, 9.0-12.6 V) -> 30 A ATO fuse -> VBAT_F -> J102 power switch / kill link -> VMOT. Q101: low-side N-MOSFET reverse-polarity protection in the ground return (D=battery -, S=GND). Gate fed from VMOT (after the switch) so nothing drains the battery when switche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
5 V BUCK (LM2596S-5.0) -> ESP32 5V pin, ELRS receiver, 74HCT244 Keep VIN cap - U101 - D103 - C103 loop tight (see LAYOUT_NOTES.md).

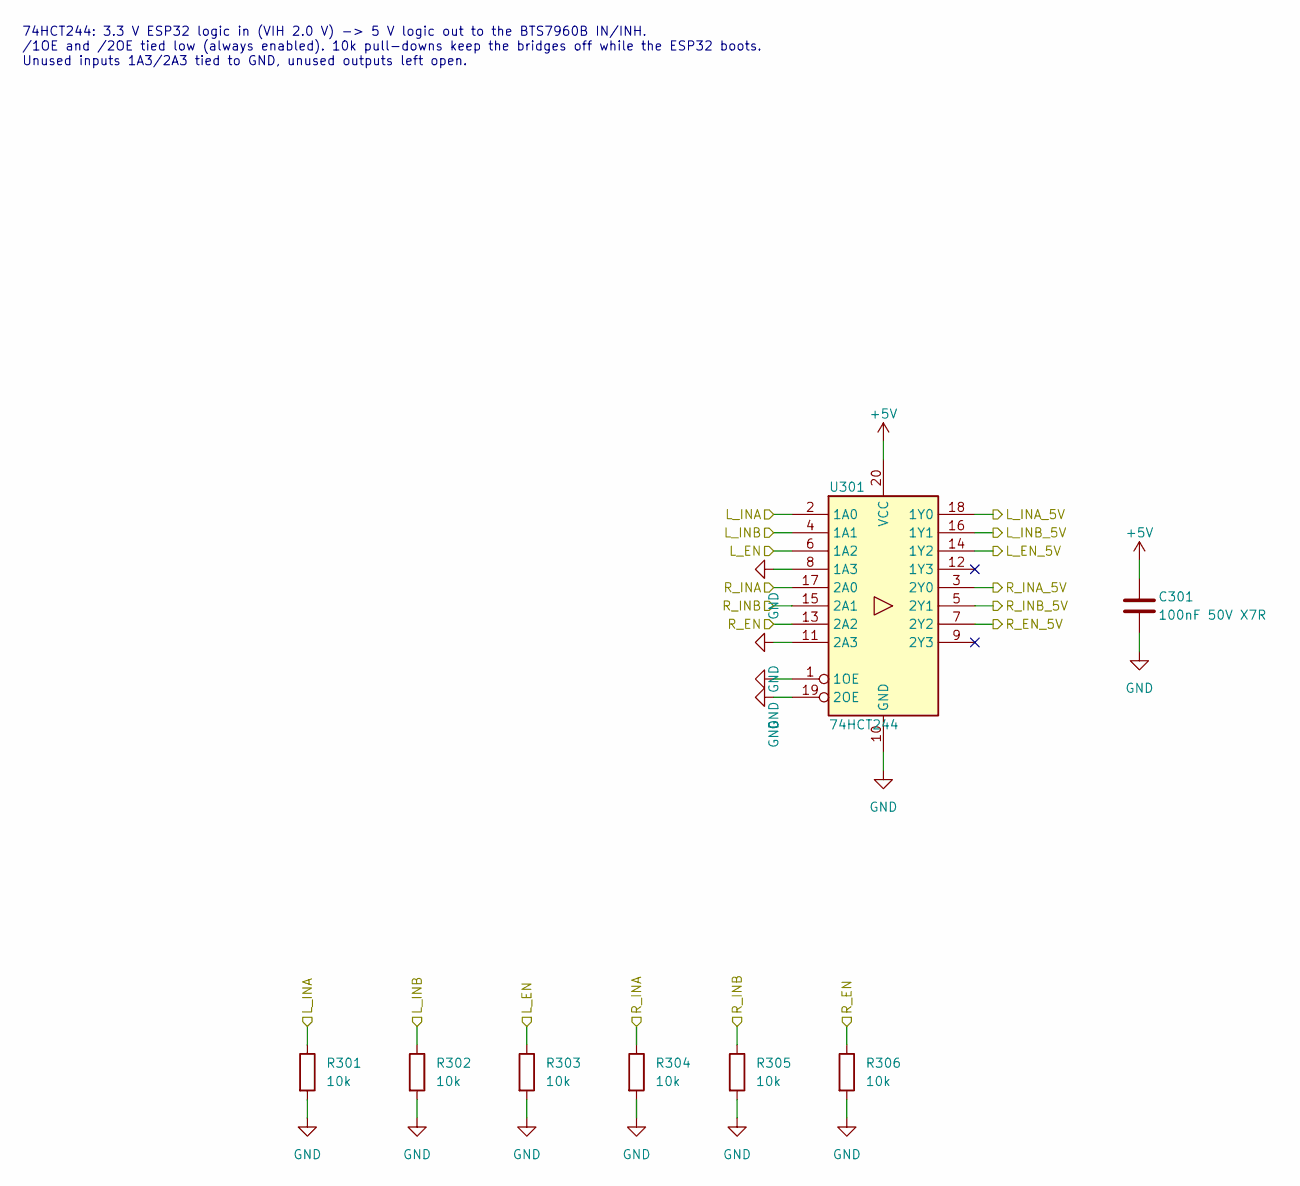
[picture p25: schematic logic_buffer.kicad_sch, racebot_main - Logic Buffer]

Parts:
C301: 100nF 50V X7R; C_0603_1608Metric; MPN CC0603KRX7R9BB104; LCSC C14663
R301, R302, R303, R304, R305, R306: 10k; R_0603_1608Metric; MPN 0603WAF1002T5E; LCSC C25804
U301: 74HCT244; SOIC-20W_7.5x12.8mm_P1.27mm; MPN 74HCT244D,653; LCSC C5978

Connections:
+5V: C301.1, U301.20 (VCC); also elsewhere on the board
/L_EN: R303.1, U301.6 (1A2); also elsewhere on the board
/L_EN_5V: U301.14 (1Y2); also elsewhere on the board
/L_INA: R301.1, U301.2 (1A0); also elsewhere on the board
/L_INA_5V: U301.18 (1Y0); also elsewhere on the board
/L_INB: R302.1, U301.4 (1A1); also elsewhere on the board
/L_INB_5V: U301.16 (1Y1); also elsewhere on the board
/R_EN: R306.1, U301.13 (2A2); also elsewhere on the board
/R_EN_5V: U301.7 (2Y2); also elsewhere on the board
/R_INA: R304.1, U301.17 (2A0); also elsewhere on the board
/R_INA_5V: U301.3 (2Y0); also elsewhere on the board
/R_INB: R305.1, U301.15 (2A1); also elsewhere on the board
/R_INB_5V: U301.5 (2Y1); also elsewhere on the board
GND: C301.2, R301.2, R302.2, R303.2, R304.2, R305.2, R306.2, U301.1 (1OE), U301.8 (1A3), U301.10 (GND), U301.11 (2A3), U301.19 (2OE); also elsewhere on the board

Notes on the sheet:
74HCT244: 3.3 V ESP32 logic in (VIH 2.0 V) -> 5 V logic out to the BTS7960B IN/INH. /1OE and /2OE tied low (always enabled). 10k pull-downs keep the bridges off while the ESP32 boots. Unused inputs 1A3/2A3 tied to GND, unused outputs left open.

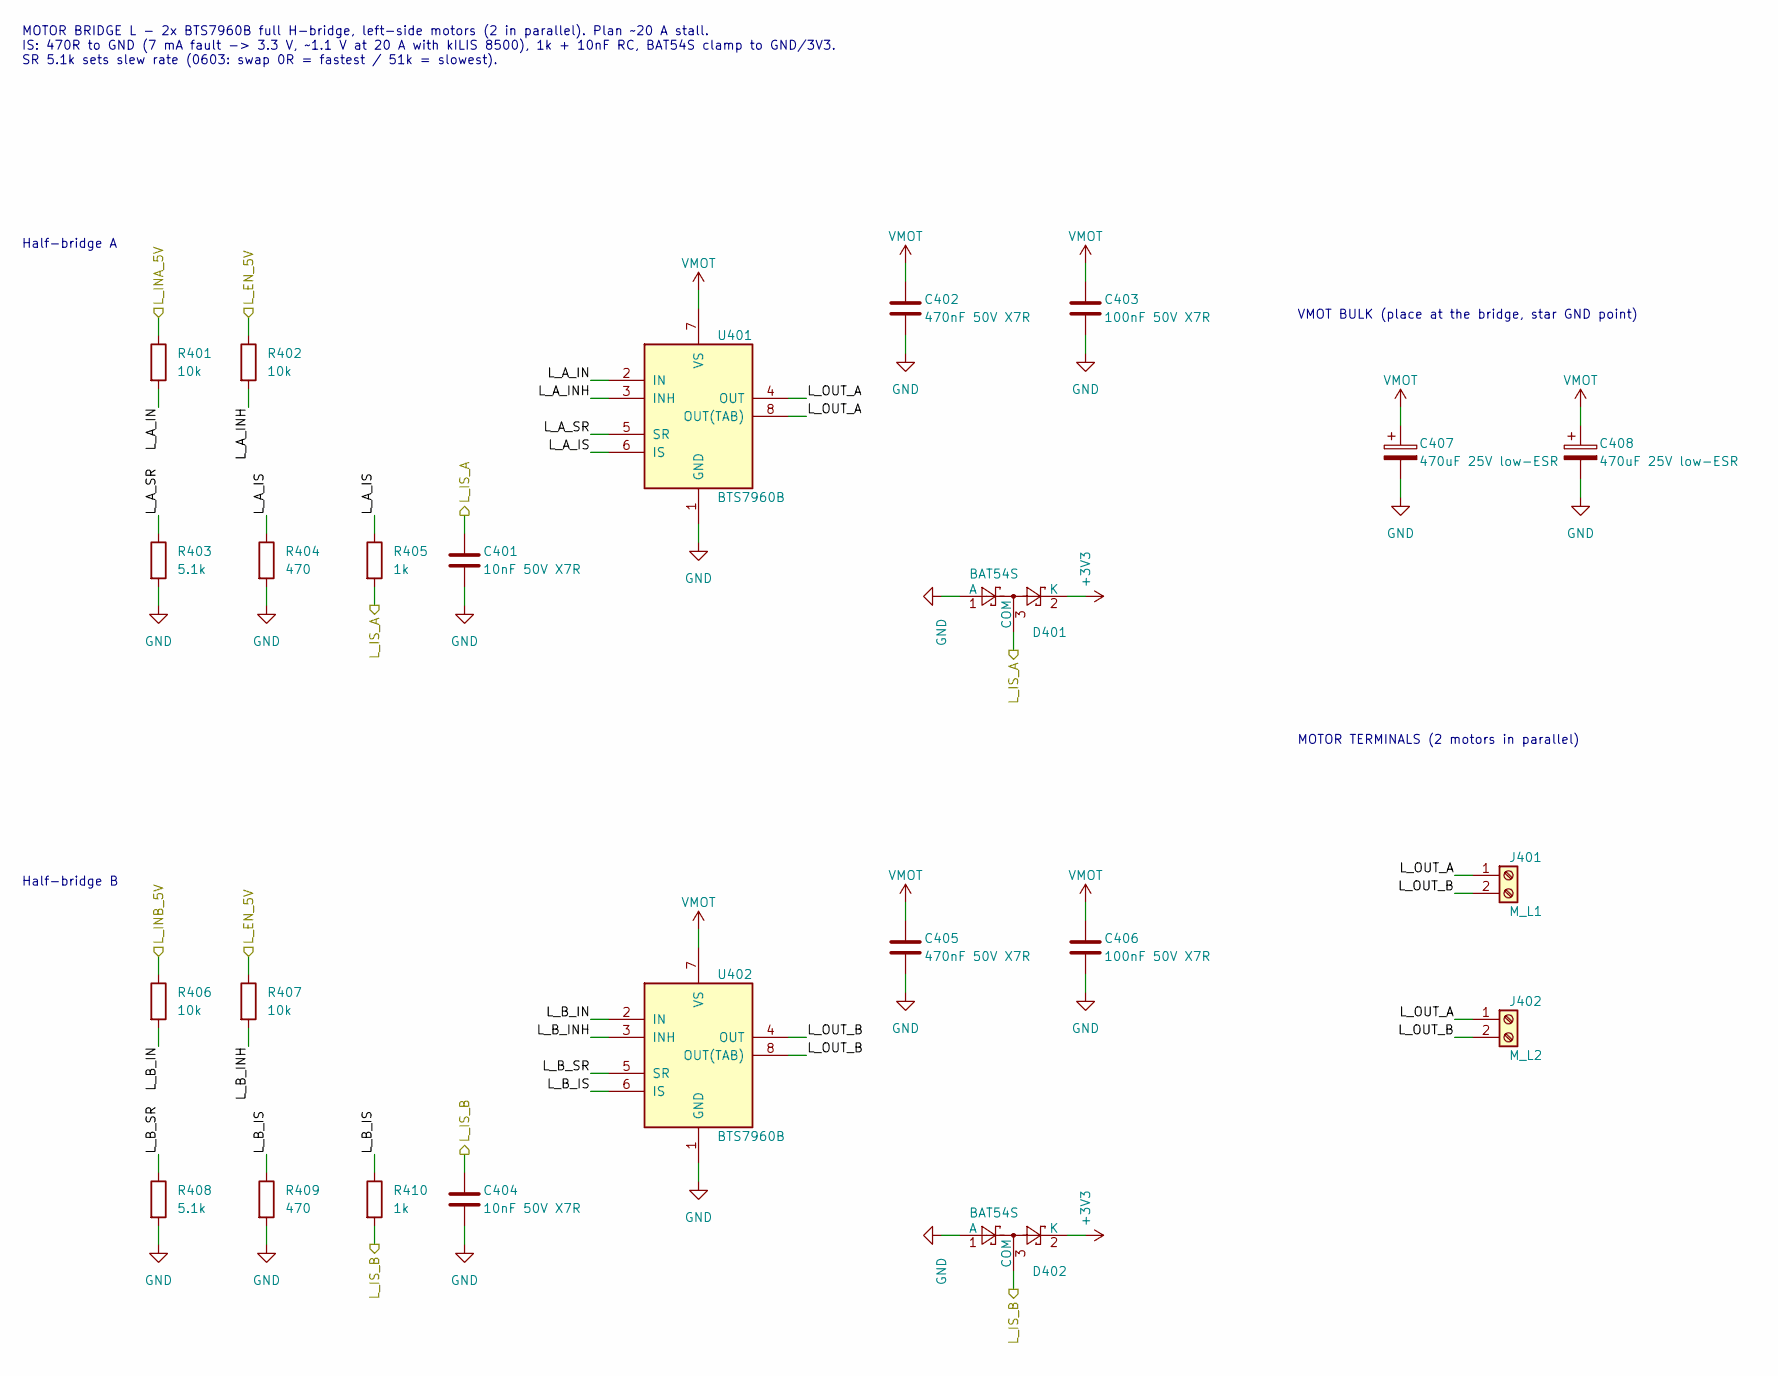
[picture p26: schematic motor_bridge_L.kicad_sch, racebot_main - Motor Bridge L]

Parts:
C401, C404: 10nF 50V X7R; C_0603_1608Metric; MPN 0603B103K500NT; LCSC C57112
C402, C405: 470nF 50V X7R; C_0805_2012Metric; MPN CL21B474KBFNNNE; LCSC C13967
C403, C406: 100nF 50V X7R; C_0603_1608Metric; MPN CC0603KRX7R9BB104; LCSC C14663
C407, C408: 470uF 25V low-ESR; CP_Radial_D10.0mm_P5.00mm; MPN GA25V470M10X12; LCSC C51018322
D401, D402: BAT54S; SOT-23; MPN BAT54S; LCSC C8592
J401: M_L1; TerminalBlock_Phoenix_MKDS-1,5-2-5.08_1x02_P5.08mm_Horizont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; MPN 1729128; LCSC C7509570
J402: M_L2; TerminalBlock_Phoenix_MKDS-1,5-2-5.08_1x02_P5.08mm_Horizont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; MPN 1729128; LCSC C7509570
R401, R402, R406, R407: 10k; R_0603_1608Metric; MPN 0603WAF1002T5E; LCSC C25804
R403, R408: 5.1k; R_0603_1608Metric; MPN 0603WAF5101T5E; LCSC C23186
R404, R409: 470; R_0603_1608Metric; MPN 0603WAF4700T5E; LCSC C23179
R405, R410: 1k; R_0603_1608Metric; MPN 0603WAF1001T5E; LCSC C21190
U401, U402: BTS7960B; TO-263-7_TabPin8; MPN BTS7960B; LCSC C5122776

Connections:
+3V3: D401.2 (K), D402.2 (K); also elsewhere on the board
/L_EN_5V: R402.1, R407.1; also elsewhere on the board
/L_INA_5V: R401.1; also elsewhere on the board
/L_INB_5V: R406.1; also elsewhere on the board
/L_IS_A: C401.1, D401.3 (COM), R405.2; also elsewhere on the board
/L_IS_B: C404.1, D402.3 (COM), R410.2; also elsewhere on the board
/Motor Bridge L/L_A_IN: R401.2, U401.2 (IN)
/Motor Bridge L/L_A_INH: R402.2, U401.3 (INH)
/Motor Bridge L/L_A_IS: R404.1, R405.1, U401.6 (IS)
/Motor Bridge L/L_A_SR: R403.1, U401.5 (SR)
/Motor Bridge L/L_B_IN: R406.2, U402.2 (IN)
/Motor Bridge L/L_B_INH: R407.2, U402.3 (INH)
/Motor Bridge L/L_B_IS: R409.1, R410.1, U402.6 (IS)
/Motor Bridge L/L_B_SR: R408.1, U402.5 (SR)
/Motor Bridge L/L_OUT_A: J401.1, J402.1, U401.4 (OUT), U401.8 (OUT(TAB))
/Motor Bridge L/L_OUT_B: J401.2, J402.2, U402.4 (OUT), U402.8 (OUT(TAB))
GND: C401.2, C402.2, C403.2, C404.2, C405.2, C406.2, C407.2, C408.2, D401.1 (A), D402.1 (A), R403.2, R404.2, R408.2, R409.2, U401.1 (GND), U402.1 (GND); also elsewhere on the board
VMOT: C402.1, C403.1, C405.1, C406.1, C407.1, C408.1, U401.7 (VS), U402.7 (VS); also elsewhere on the board

Notes on the sheet:
MOTOR BRIDGE L - 2x BTS7960B full H-bridge, left-side motors (2 in parallel). Plan ~20 A stall. IS: 470R to GND (7 mA fault -> 3.3 V, ~1.1 V at 20 A with kILIS 8500), 1k + 10nF RC, BAT54S clamp to GND/3V3. SR 5.1k sets slew rate (0603: swap 0R = fastest / 51k = slowest).
VMOT BULK (place at the bridge, star GND point)
MOTOR TERMINALS (2 motors in parallel)
Half-bridge A
Half-bridge B

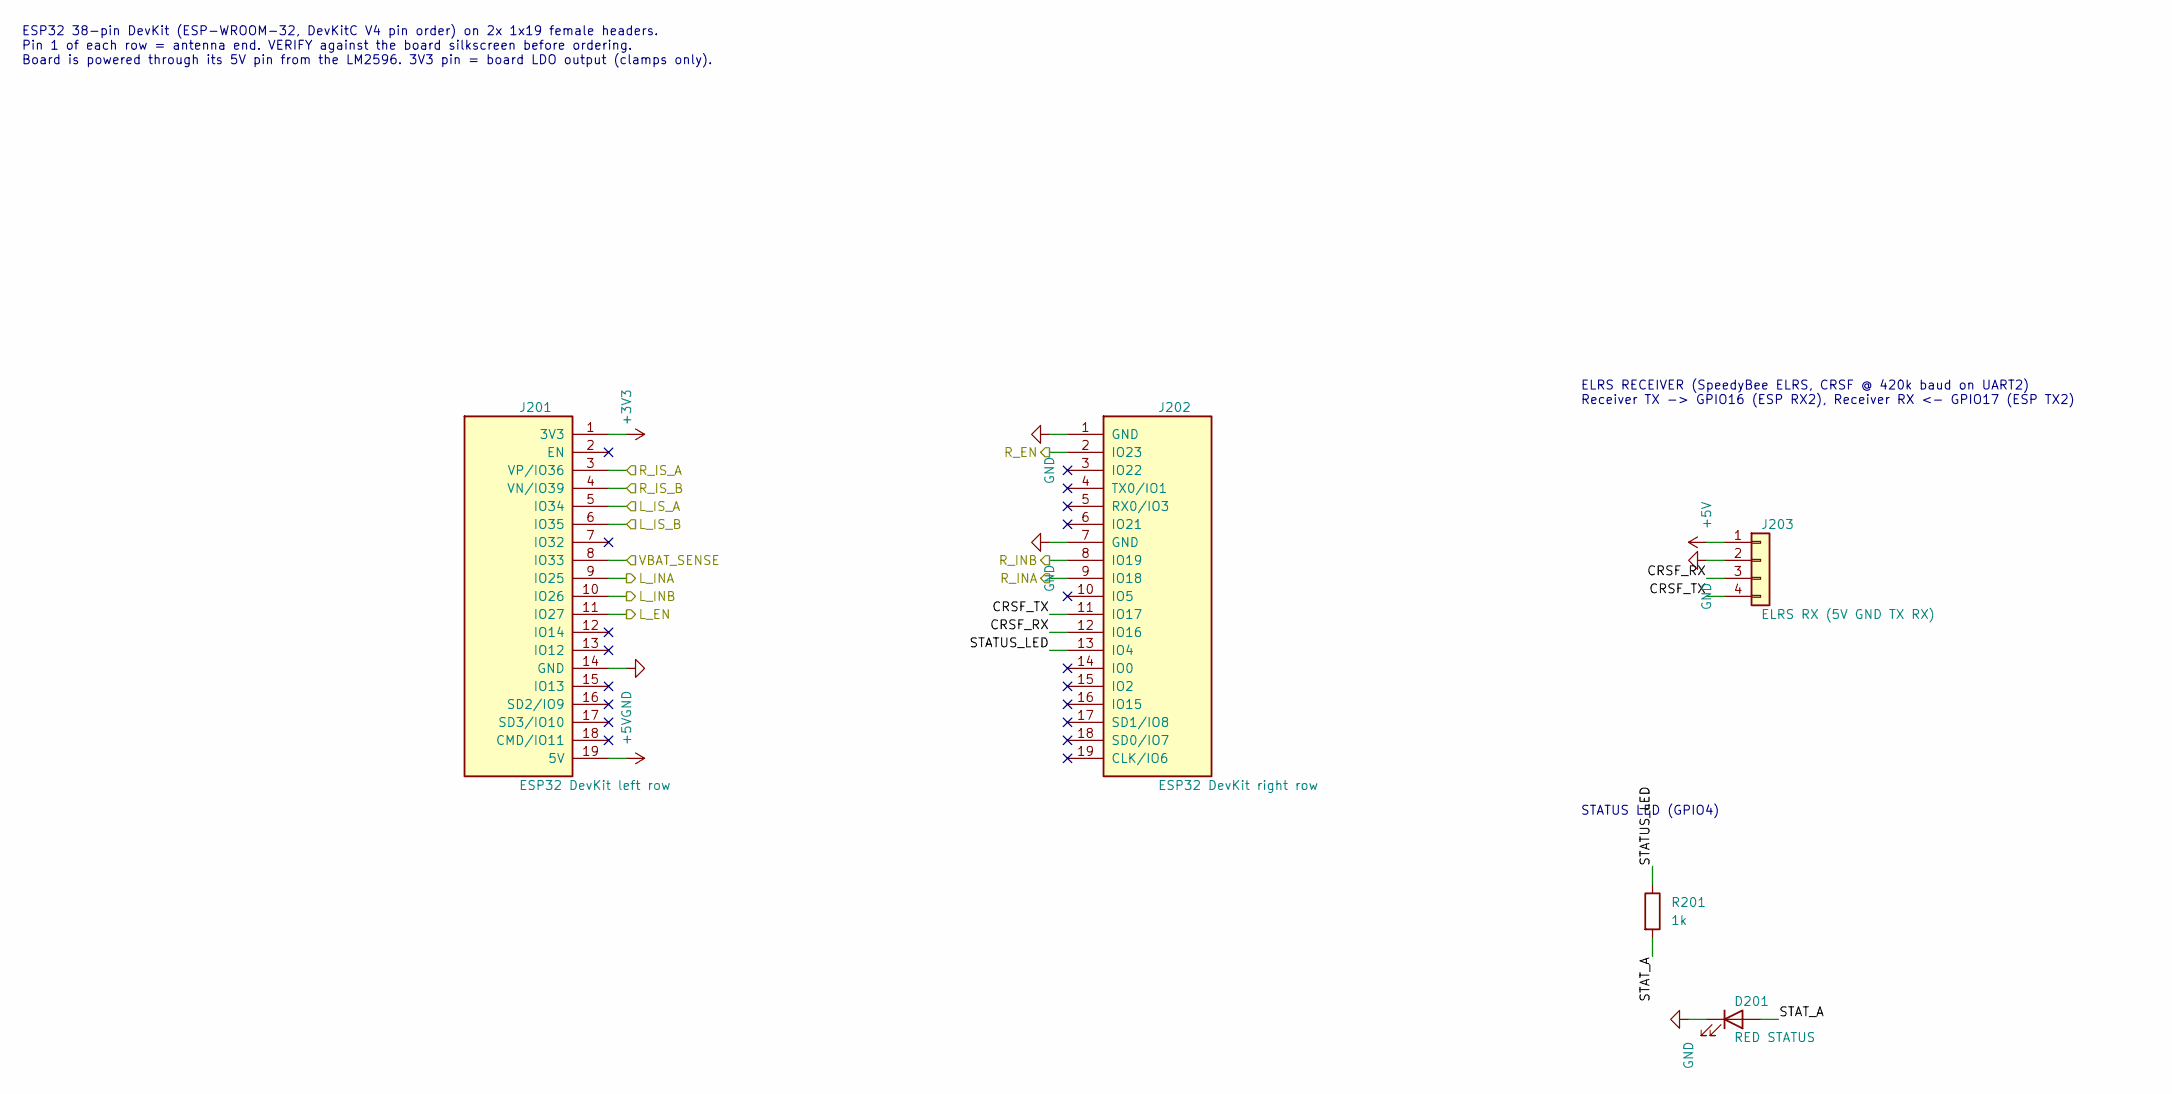
[picture p27: schematic mcu_rx.kicad_sch, racebot_main - MCU+RX]

Parts:
D201: RED STATUS; LED_0603_1608Metric; MPN KT-0603R; LCSC C2286
J201: ESP32 DevKit left row; PinSocket_1x19_P2.54mm_Vertical; MPN 2.54-1*19PFemale; LCSC C319202
J202: ESP32 DevKit right row; PinSocket_1x19_P2.54mm_Vertical; MPN 2.54-1*19PFemale; LCSC C319202
J203: ELRS RX (5V GND TX RX); PinHeader_1x04_P2.54mm_Vertical; MPN PZ254V-11-04P; LCSC C492403
R201: 1k; R_0603_1608Metric; MPN 0603WAF1001T5E; LCSC C21190

Connections:
+3V3: J201.1 (3V3); also elsewhere on the board
+5V: J201.19 (5V), J203.1; also elsewhere on the board
/L_EN: J201.11 (IO27); also elsewhere on the board
/L_INA: J201.9 (IO25); also elsewhere on the board
/L_INB: J201.10 (IO26); also elsewhere on the board
/L_IS_A: J201.5 (IO34); also elsewhere on the board
/L_IS_B: J201.6 (IO35); also elsewhere on the board
/MCU+RX/CRSF_RX: J202.12 (IO16), J203.3
/MCU+RX/CRSF_TX: J202.11 (IO17), J203.4
/MCU+RX/STATUS_LED: J202.13 (IO4), R201.1
/MCU+RX/STAT_A: D201.2 (A), R201.2
/R_EN: J202.2 (IO23); also elsewhere on the board
/R_INA: J202.9 (IO18); also elsewhere on the board
/R_INB: J202.8 (IO19); also elsewhere on the board
/R_IS_A: J201.3 (VP/IO36); also elsewhere on the board
/R_IS_B: J201.4 (VN/IO39); also elsewhere on the board
/VBAT_SENSE: J201.8 (IO33); also elsewhere on the board
GND: D201.1 (K), J201.14 (GND), J202.1 (GND), J202.7 (GND), J203.2; also elsewhere on the board

Notes on the sheet:
ELRS RECEIVER (SpeedyBee ELRS, CRSF @ 420k baud on UART2) Receiver TX -> GPIO16 (ESP RX2), Receiver RX <- GPIO17 (ESP TX2)
ESP32 38-pin DevKit (ESP-WROOM-32, DevKitC V4 pin order) on 2x 1x19 female headers. Pin 1 of each row = antenna end. VERIFY against the board silkscreen before ordering. Board is powered through its 5V pin from the LM2596. 3V3 pin = board LDO output (clamps only).
STATUS LED (GPIO4)

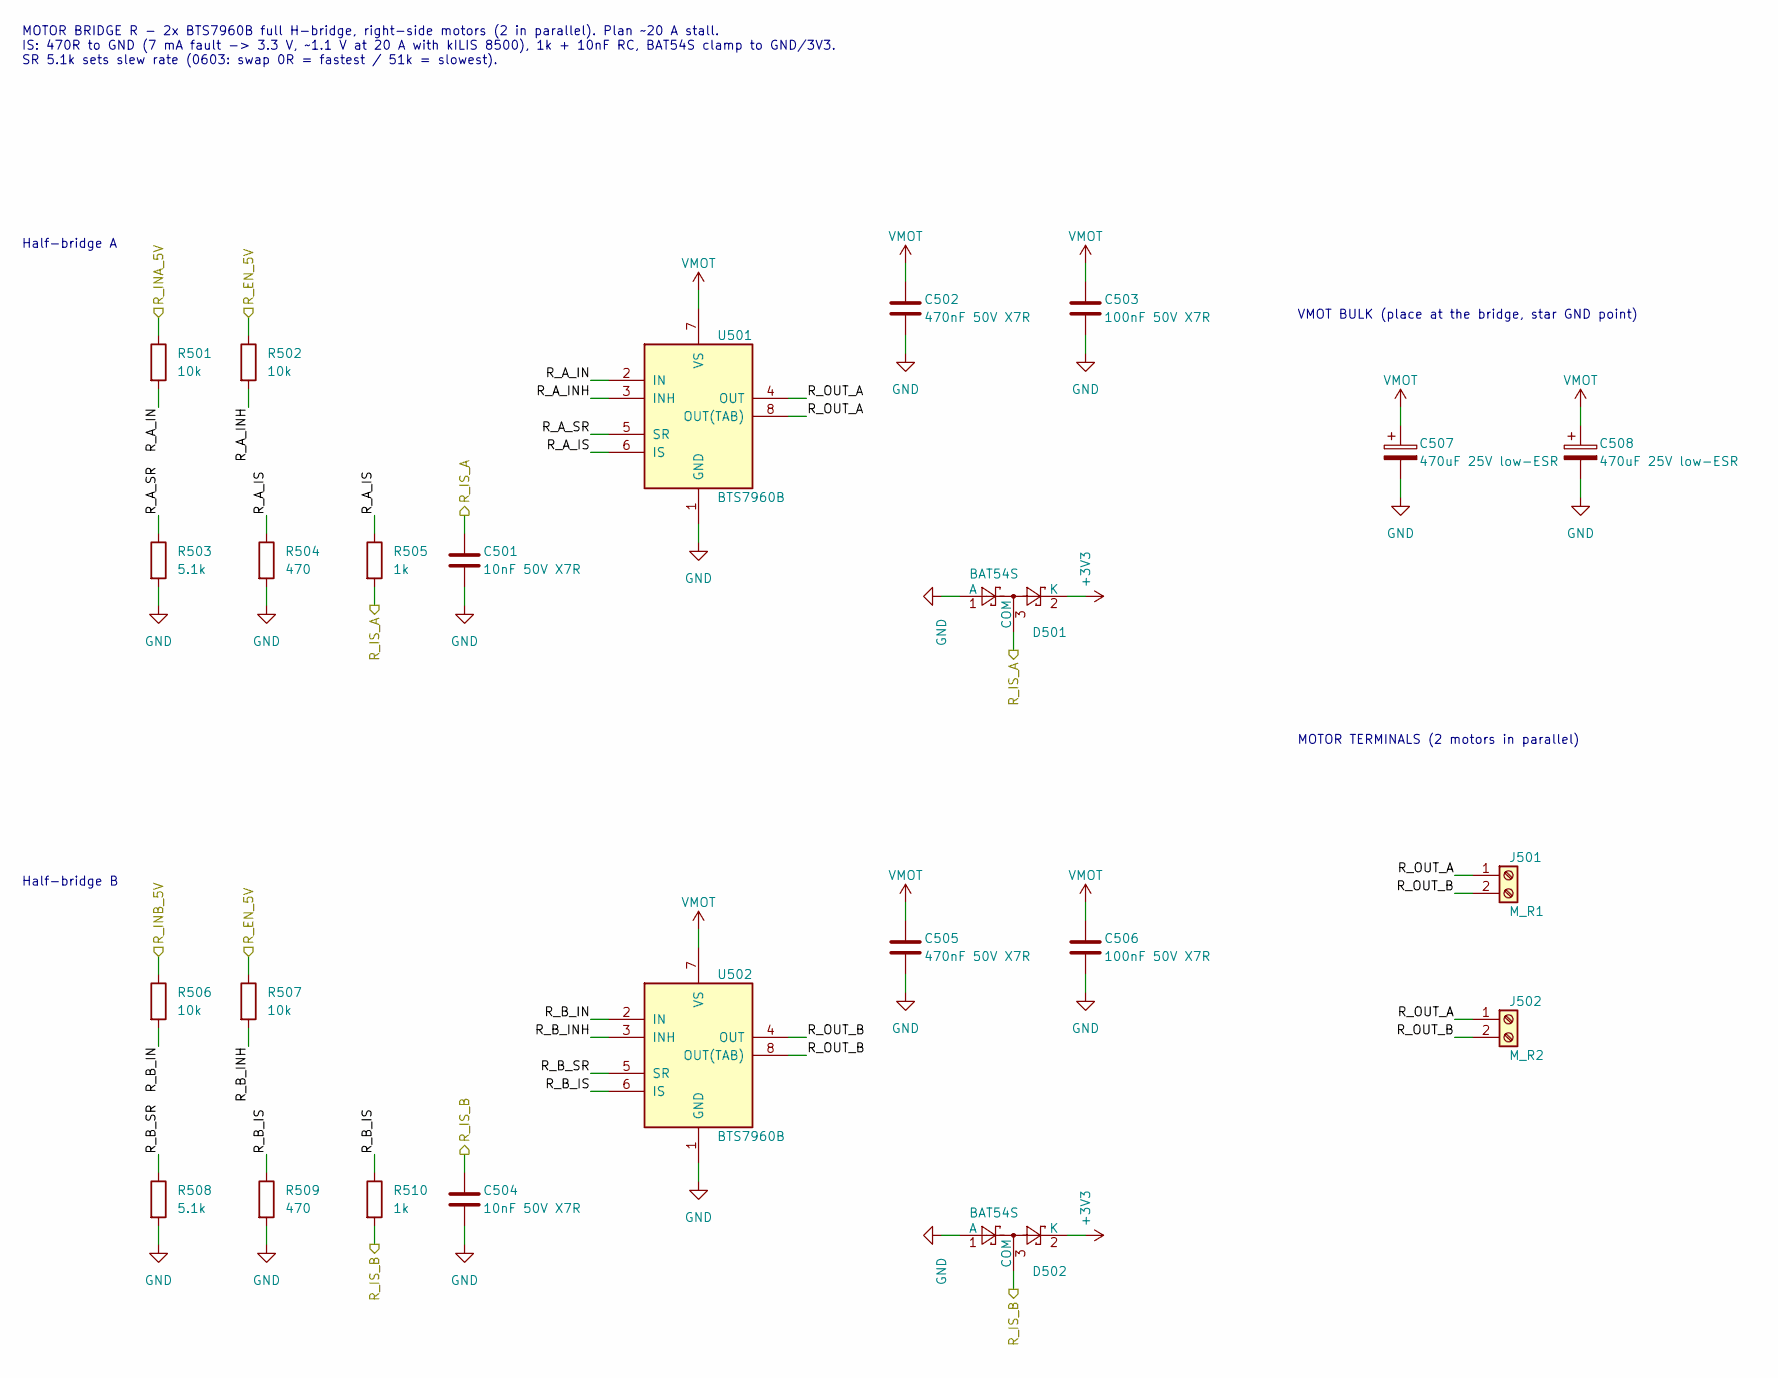
[picture p28: schematic motor_bridge_R.kicad_sch, racebot_main - Motor Bridge R]

Parts:
C501, C504: 10nF 50V X7R; C_0603_1608Metric; MPN 0603B103K500NT; LCSC C57112
C502, C505: 470nF 50V X7R; C_0805_2012Metric; MPN CL21B474KBFNNNE; LCSC C13967
C503, C506: 100nF 50V X7R; C_0603_1608Metric; MPN CC0603KRX7R9BB104; LCSC C14663
C507, C508: 470uF 25V low-ESR; CP_Radial_D10.0mm_P5.00mm; MPN GA25V470M10X12; LCSC C51018322
D501, D502: BAT54S; SOT-23; MPN BAT54S; LCSC C8592
J501: M_R1; TerminalBlock_Phoenix_MKDS-1,5-2-5.08_1x02_P5.08mm_Horizont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; MPN 1729128; LCSC C7509570
J502: M_R2; TerminalBlock_Phoenix_MKDS-1,5-2-5.08_1x02_P5.08mm_Horizont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; MPN 1729128; LCSC C7509570
R501, R502, R506, R507: 10k; R_0603_1608Metric; MPN 0603WAF1002T5E; LCSC C25804
R503, R508: 5.1k; R_0603_1608Metric; MPN 0603WAF5101T5E; LCSC C23186
R504, R509: 470; R_0603_1608Metric; MPN 0603WAF4700T5E; LCSC C23179
R505, R510: 1k; R_0603_1608Metric; MPN 0603WAF1001T5E; LCSC C21190
U501, U502: BTS7960B; TO-263-7_TabPin8; MPN BTS7960B; LCSC C5122776

Connections:
+3V3: D501.2 (K), D502.2 (K); also elsewhere on the board
/Motor Bridge R/R_A_IN: R501.2, U501.2 (IN)
/Motor Bridge R/R_A_INH: R502.2, U501.3 (INH)
/Motor Bridge R/R_A_IS: R504.1, R505.1, U501.6 (IS)
/Motor Bridge R/R_A_SR: R503.1, U501.5 (SR)
/Motor Bridge R/R_B_IN: R506.2, U502.2 (IN)
/Motor Bridge R/R_B_INH: R507.2, U502.3 (INH)
/Motor Bridge R/R_B_IS: R509.1, R510.1, U502.6 (IS)
/Motor Bridge R/R_B_SR: R508.1, U502.5 (SR)
/R_EN_5V: R502.1, R507.1; also elsewhere on the board
/R_INA_5V: R501.1; also elsewhere on the board
/R_INB_5V: R506.1; also elsewhere on the board
/R_IS_A: C501.1, D501.3 (COM), R505.2; also elsewhere on the board
/R_IS_B: C504.1, D502.3 (COM), R510.2; also elsewhere on the board
GND: C501.2, C502.2, C503.2, C504.2, C505.2, C506.2, C507.2, C508.2, D501.1 (A), D502.1 (A), R503.2, R504.2, R508.2, R509.2, U501.1 (GND), U502.1 (GND); also elsewhere on the board
VMOT: C502.1, C503.1, C505.1, C506.1, C507.1, C508.1, U501.7 (VS), U502.7 (VS); also elsewhere on the board

Notes on the sheet:
Half-bridge B
MOTOR TERMINALS (2 motors in parallel)
MOTOR BRIDGE R - 2x BTS7960B full H-bridge, right-side motors (2 in parallel). Plan ~20 A stall. IS: 470R to GND (7 mA fault -> 3.3 V, ~1.1 V at 20 A with kILIS 8500), 1k + 10nF RC, BAT54S clamp to GND/3V3. SR 5.1k sets slew rate (0603: swap 0R = fastest / 51k = slowest).
Half-bridge A
VMOT BULK (place at the bridge, star GND point)

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
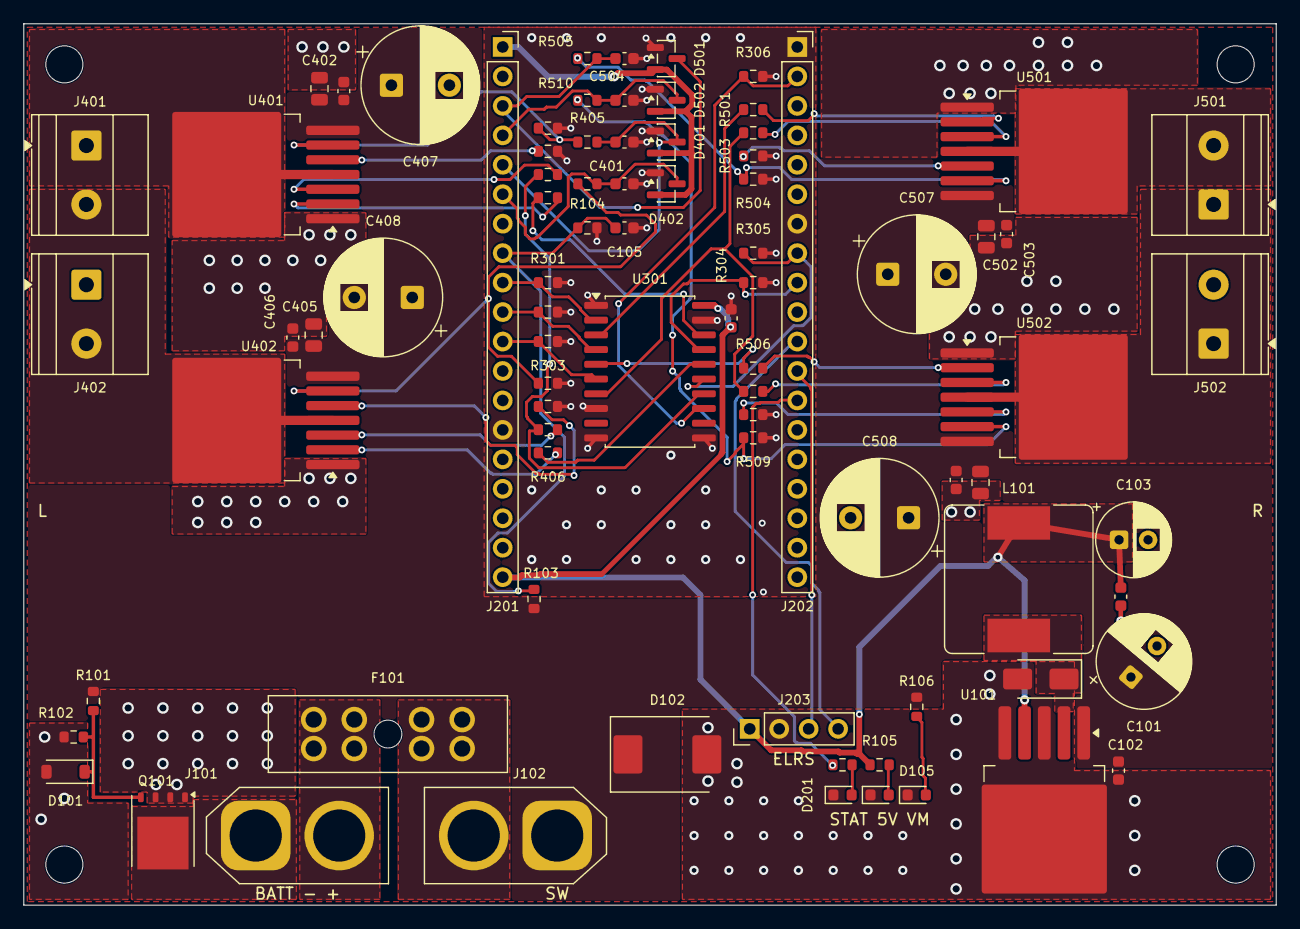
[picture p29: board racebot_main.kicad_pcb from above]

Board: 2 copper layers, 108.0 x 76.0 mm, 87 parts (0 on the bottom side), 52 nets.

Other parts of the board:
H1, H2, H3, H4: M3; MountingHole_3.2mm_M3
